kalutes/FRCDriversStation/Driver's Station Documentation/Board Easy Reference/Analog Breakout Board.png

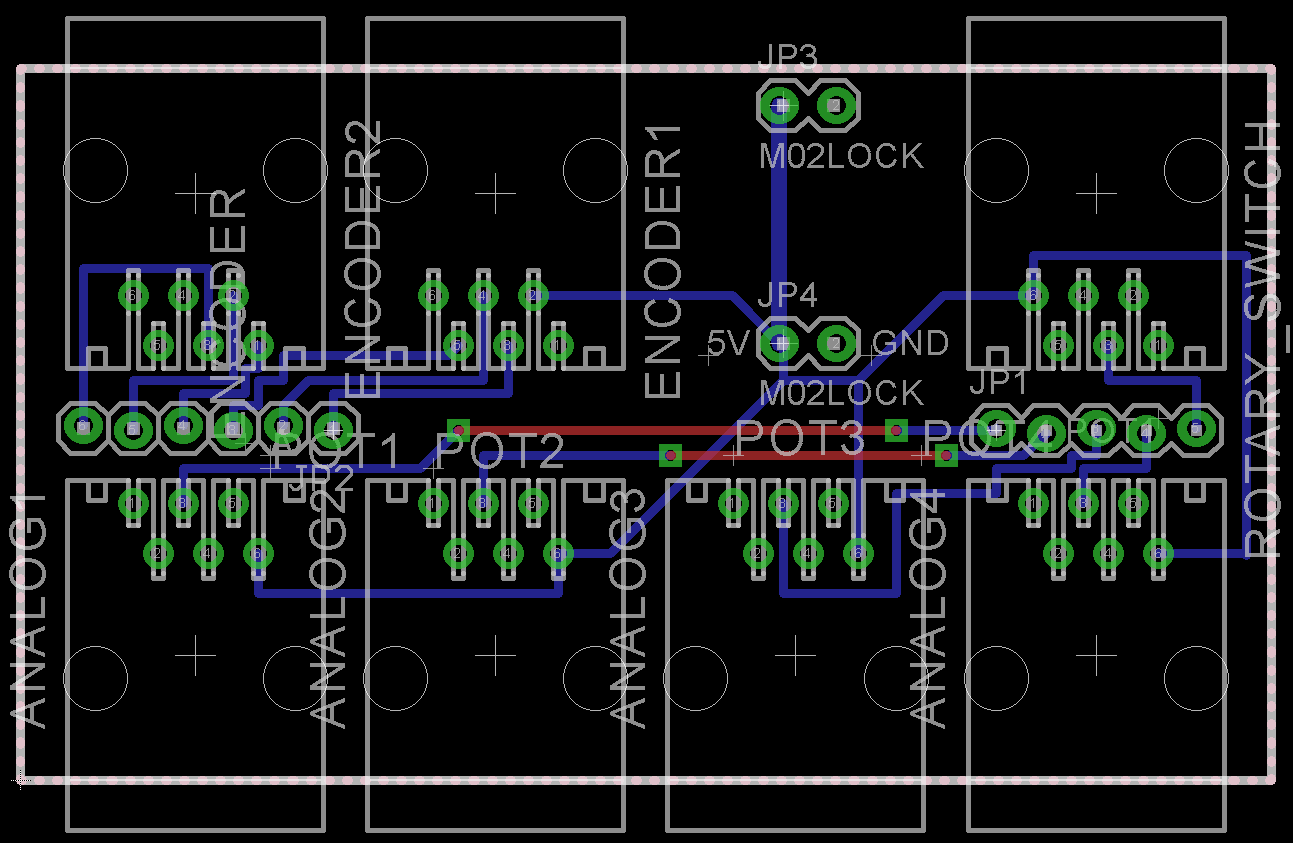
Driver's Station Documentation/Board Easy Reference/Analog Breakout Board.png
