kalutes/FRCDriversStation/Driver's Station Documentation/Board Easy Reference/Analog Breakout Schematic.png

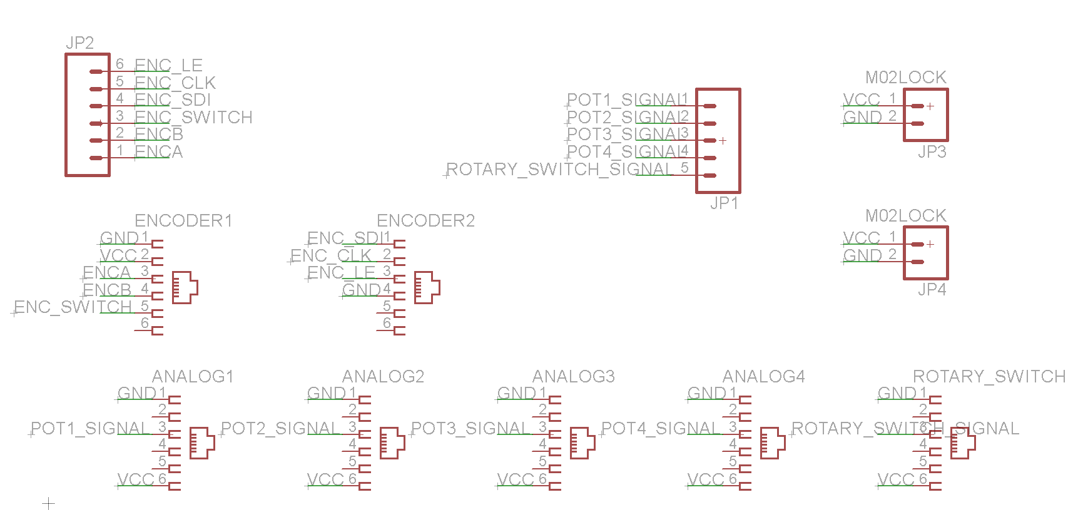
Driver's Station Documentation/Board Easy Reference/Analog Breakout Schematic.png
