kalutes/FRCDriversStation/Driver's Station Documentation/Board Easy Reference/Arduino Mega Breakout Board.png

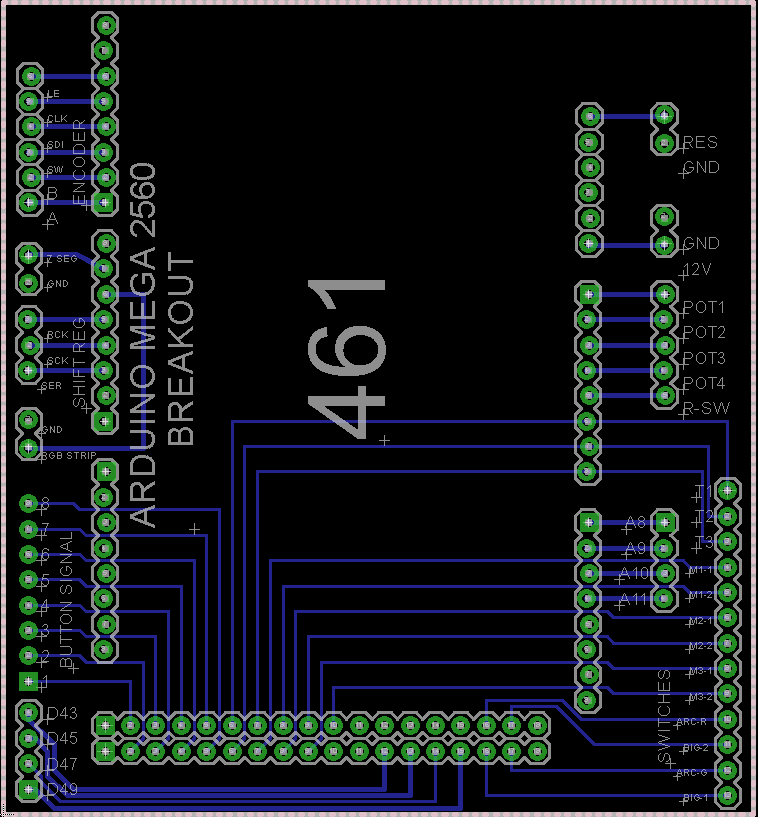
Driver's Station Documentation/Board Easy Reference/Arduino Mega Breakout Board.png
