kalutes/FRCDriversStation/Driver's Station Documentation/Board Easy Reference/Arduino Mega Breakout Schematic.png

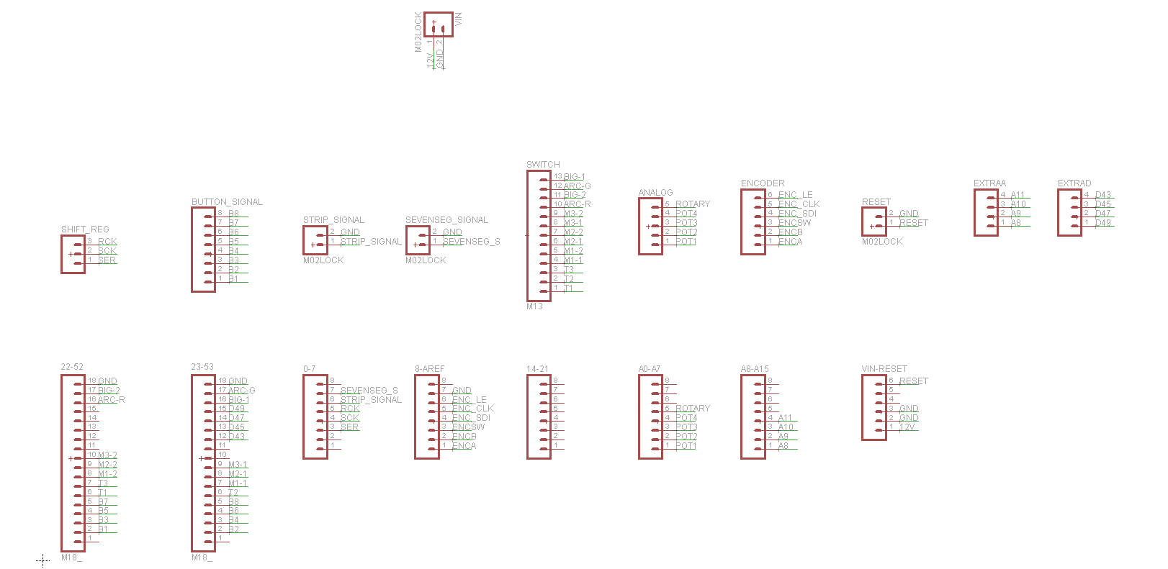
Driver's Station Documentation/Board Easy Reference/Arduino Mega Breakout Schematic.png
