kalutes/FRCDriversStation/Driver's Station Documentation/Board Easy Reference/LED Board Board.png

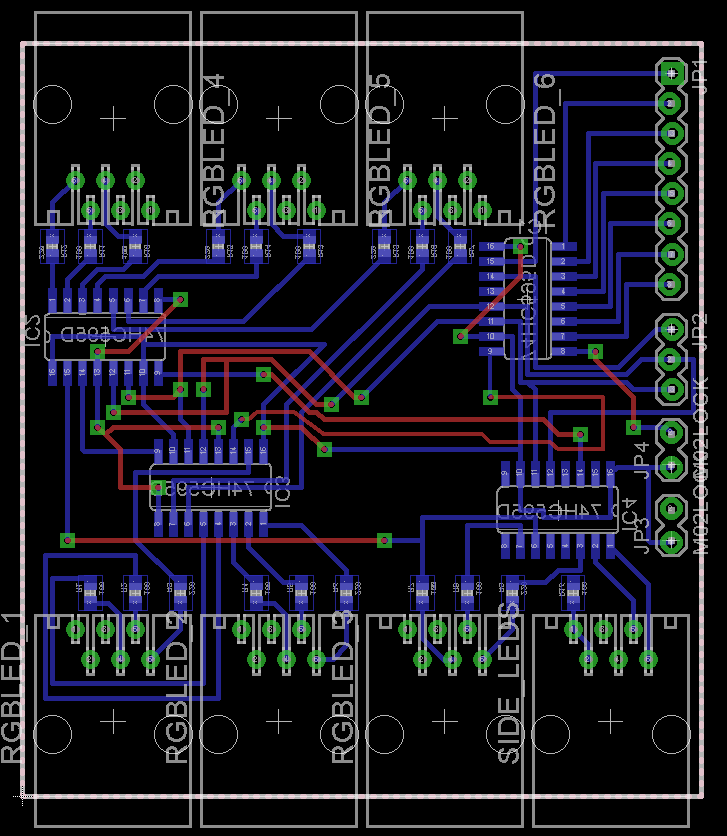
Driver's Station Documentation/Board Easy Reference/LED Board Board.png
