kalutes/FRCDriversStation/Driver's Station Documentation/Board Easy Reference/LED Board Schematic.png

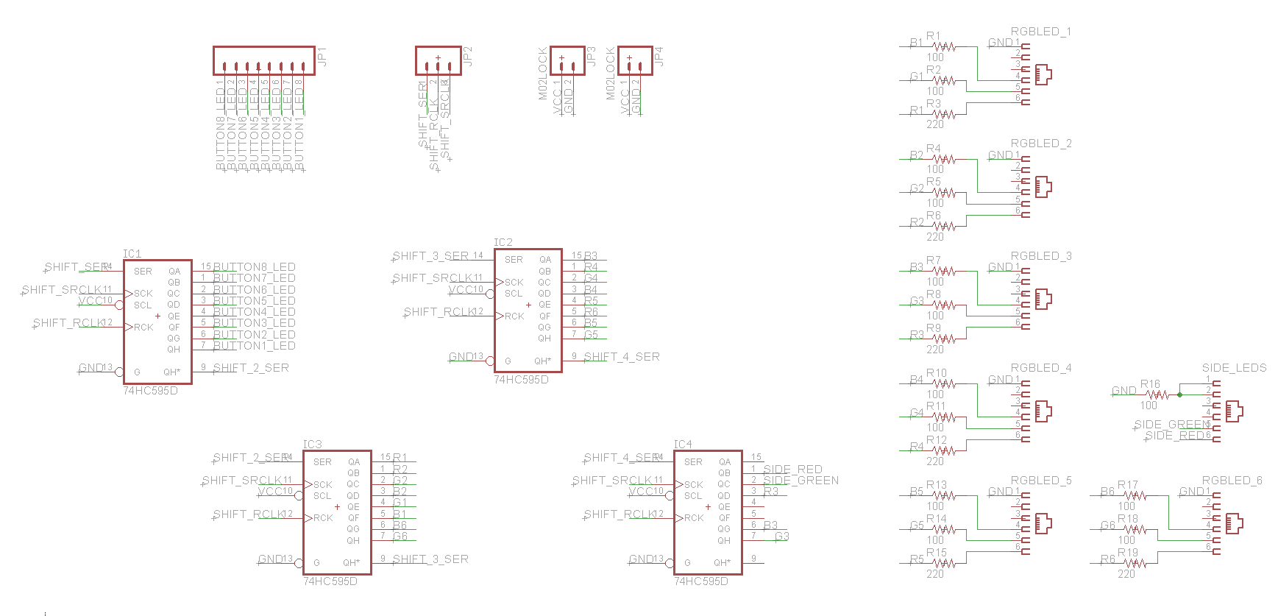
Driver's Station Documentation/Board Easy Reference/LED Board Schematic.png
