kalutes/FRCDriversStation/Driver's Station Documentation/Board Easy Reference/Pushbutton Breakout Board.png

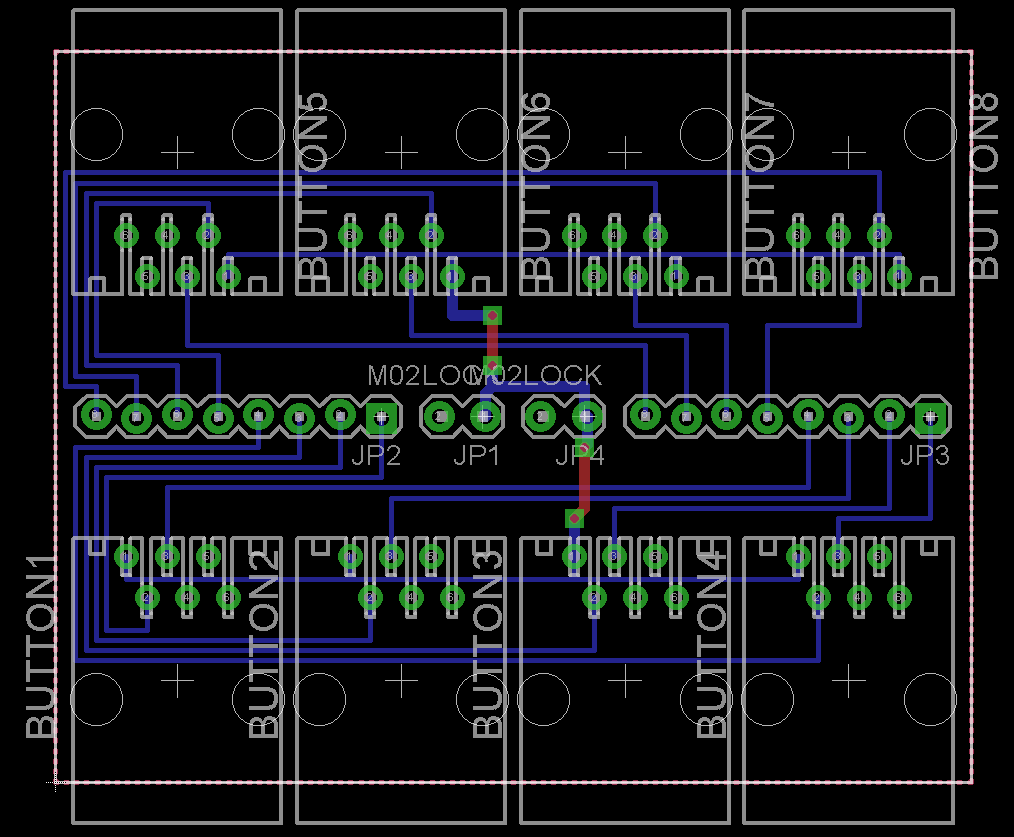
Driver's Station Documentation/Board Easy Reference/Pushbutton Breakout Board.png
