kalutes/FRCDriversStation/Driver's Station Documentation/Board Easy Reference/Pushbutton Breakout Schematic.png

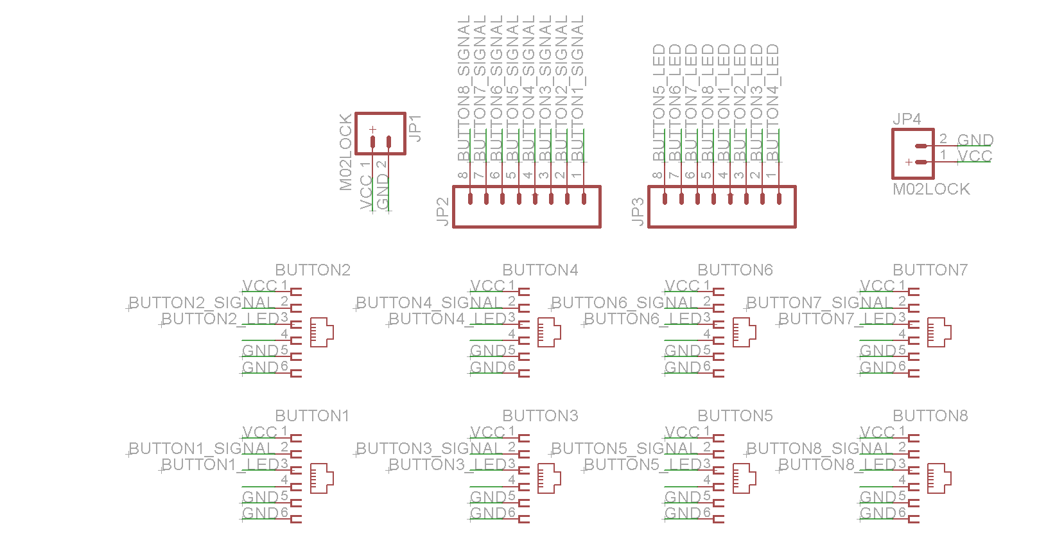
Driver's Station Documentation/Board Easy Reference/Pushbutton Breakout Schematic.png
