kalutes/FRCDriversStation/Driver's Station Documentation/Board Easy Reference/RGB LED Strips Board.png

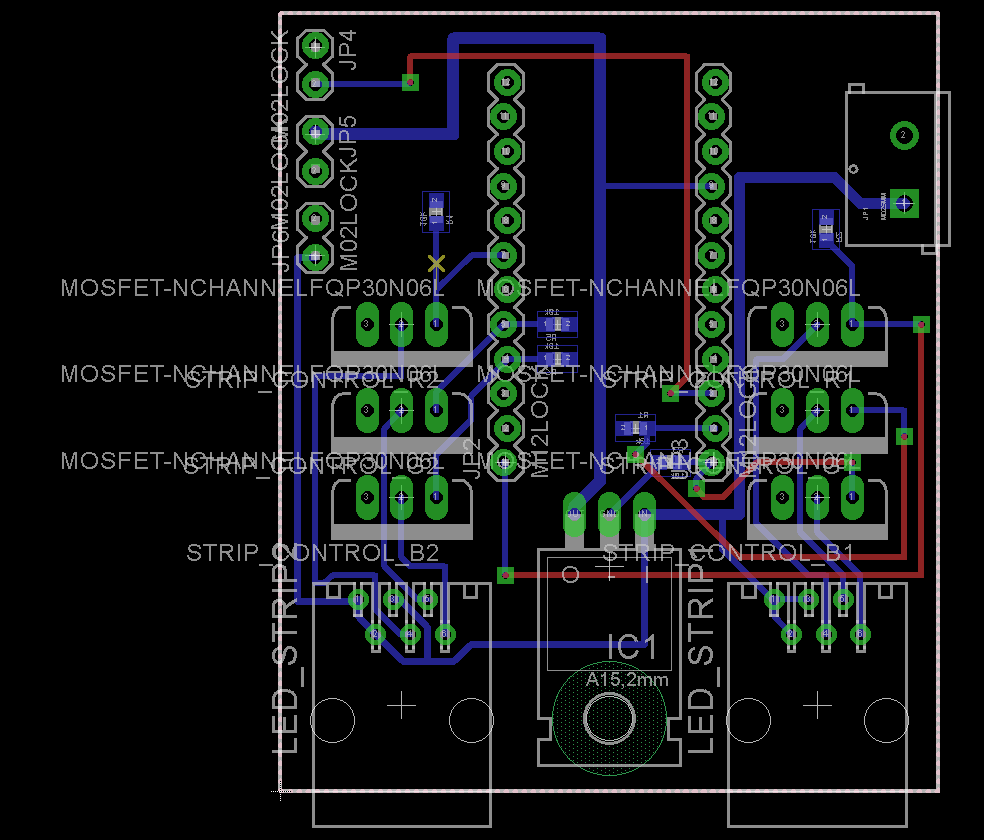
Driver's Station Documentation/Board Easy Reference/RGB LED Strips Board.png
