kalutes/FRCDriversStation/Driver's Station Documentation/Board Easy Reference/RGB LED Strips Schematic.png

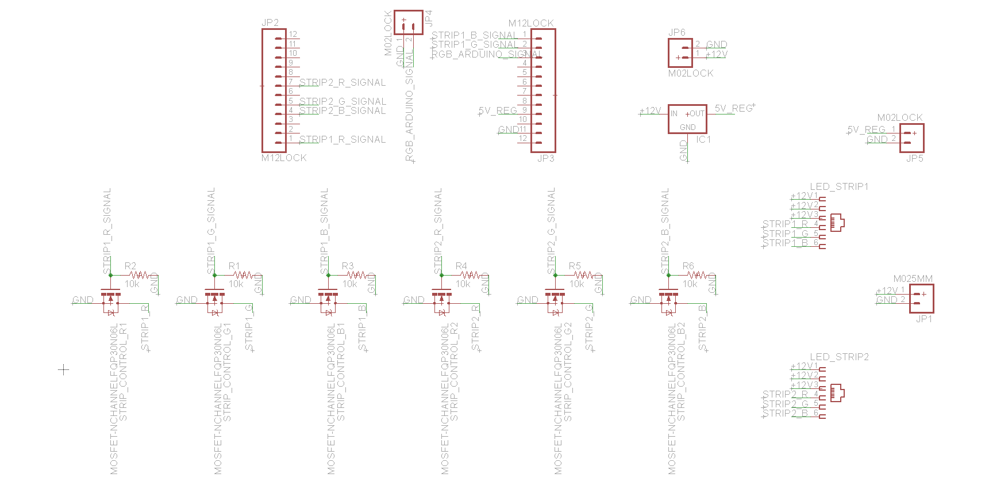
Driver's Station Documentation/Board Easy Reference/RGB LED Strips Schematic.png
