kalutes/FRCDriversStation/Driver's Station Documentation/Board Easy Reference/Seven Seg Control Board.png

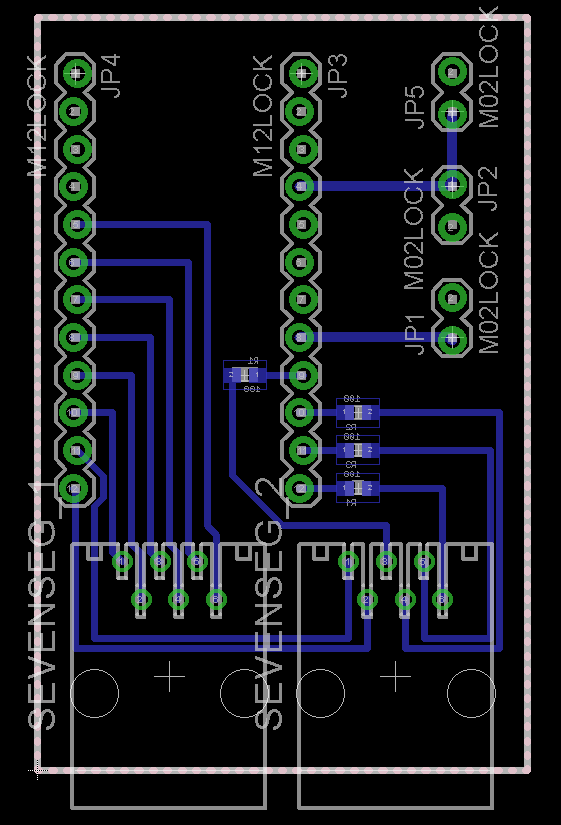
Driver's Station Documentation/Board Easy Reference/Seven Seg Control Board.png
