kalutes/FRCDriversStation/Driver's Station Documentation/Board Easy Reference/Seven Seg Control Schematic.png

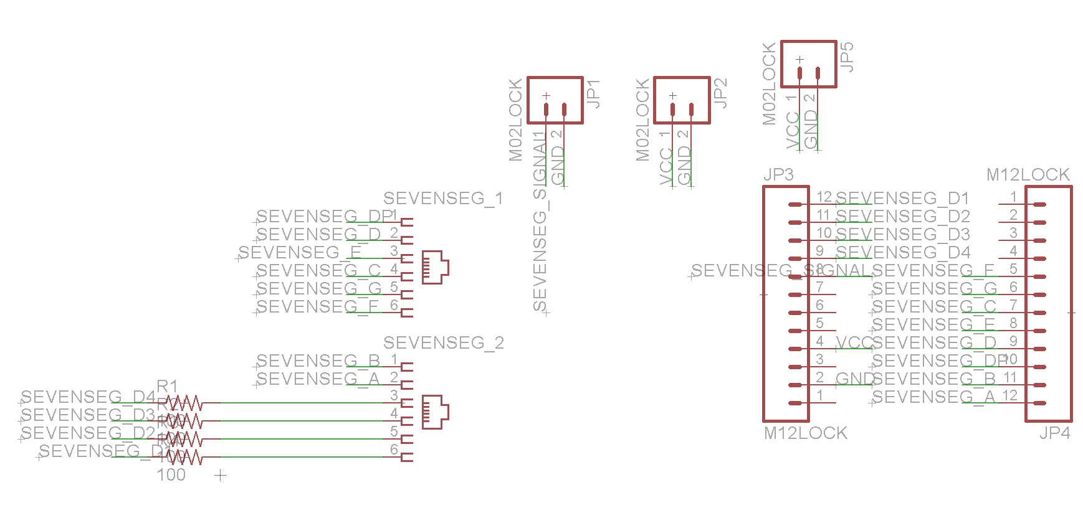
Driver's Station Documentation/Board Easy Reference/Seven Seg Control Schematic.png
