kalutes/FRCDriversStation/Driver's Station Documentation/Board Easy Reference/Switch Breakout Board.png

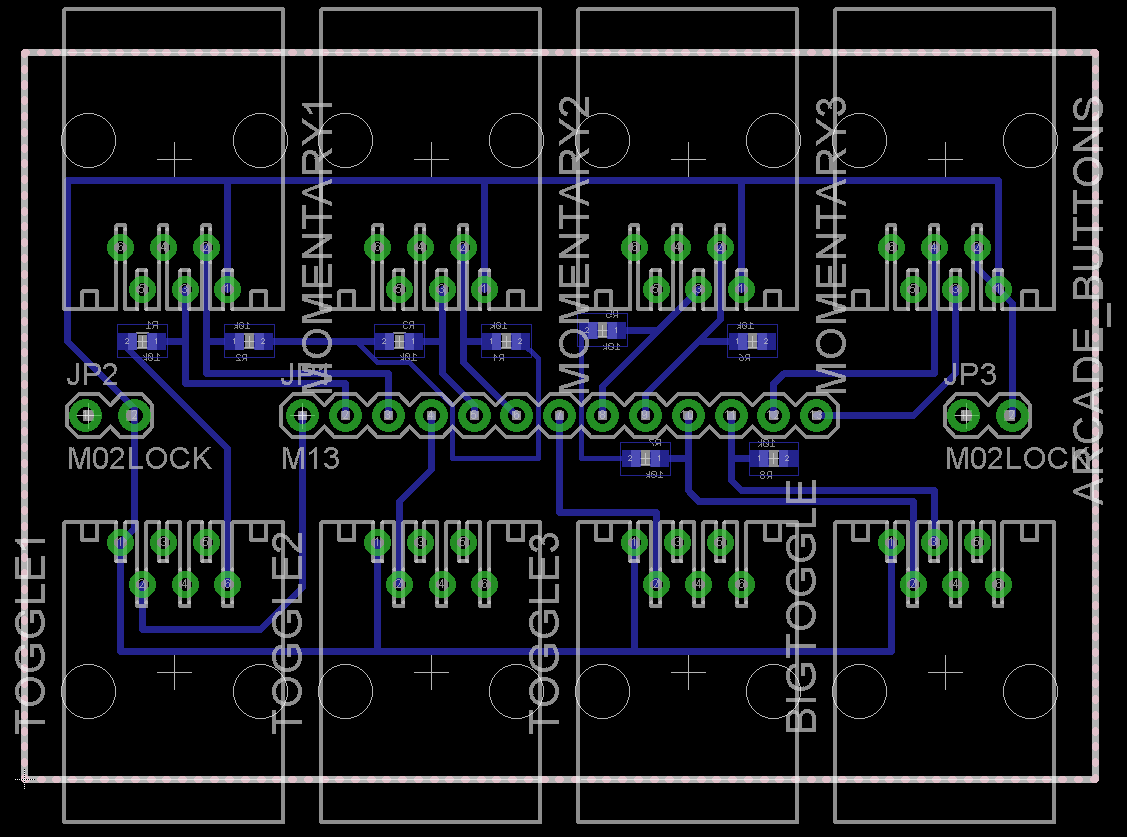
Driver's Station Documentation/Board Easy Reference/Switch Breakout Board.png
