kalutes/FRCDriversStation/Driver's Station Documentation/Board Easy Reference/Switch Breakout Schematic.png

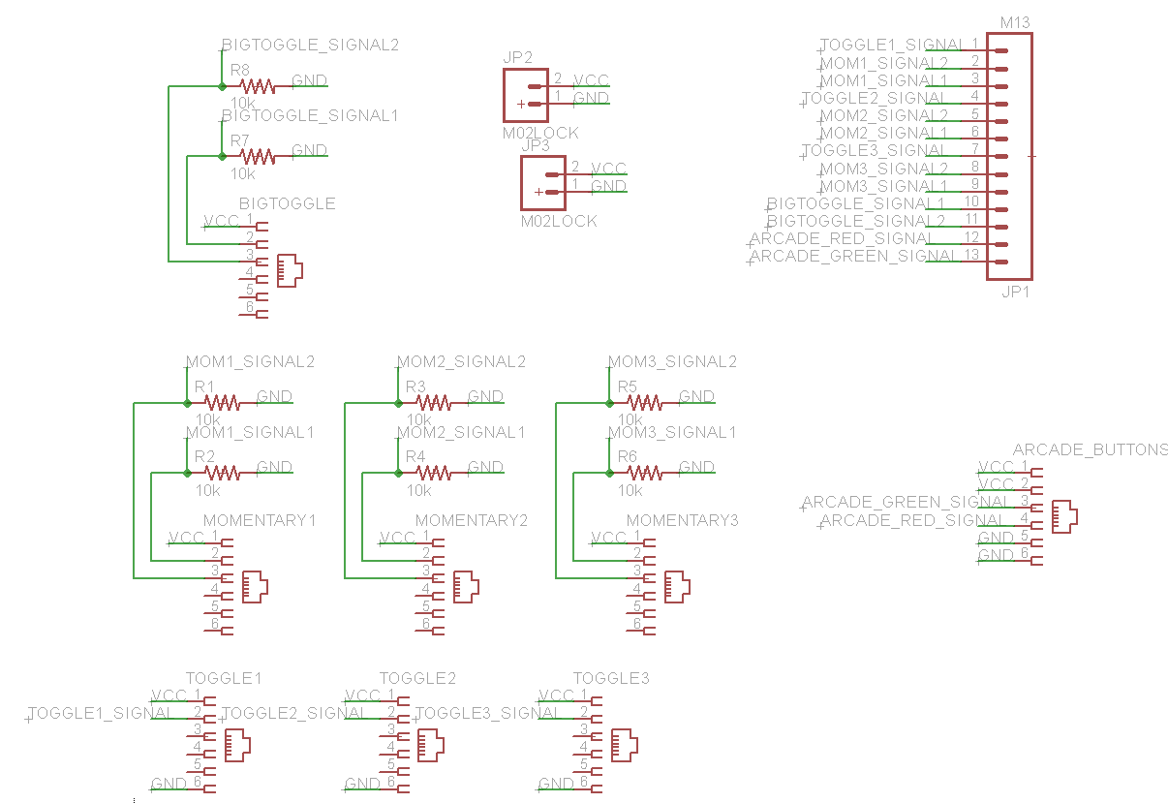
Driver's Station Documentation/Board Easy Reference/Switch Breakout Schematic.png
