kalutes/FRCDriversStation/Driver's Station Documentation/Eagle Files/Pushbutton Breakout/Pushbutton Breakout - Schematic.brd

## EAGLE design Driver's Station Documentation/Eagle Files/Pushbutton Breakout/Pushbutton Breakout - Schematic.brd (2016-06-20)

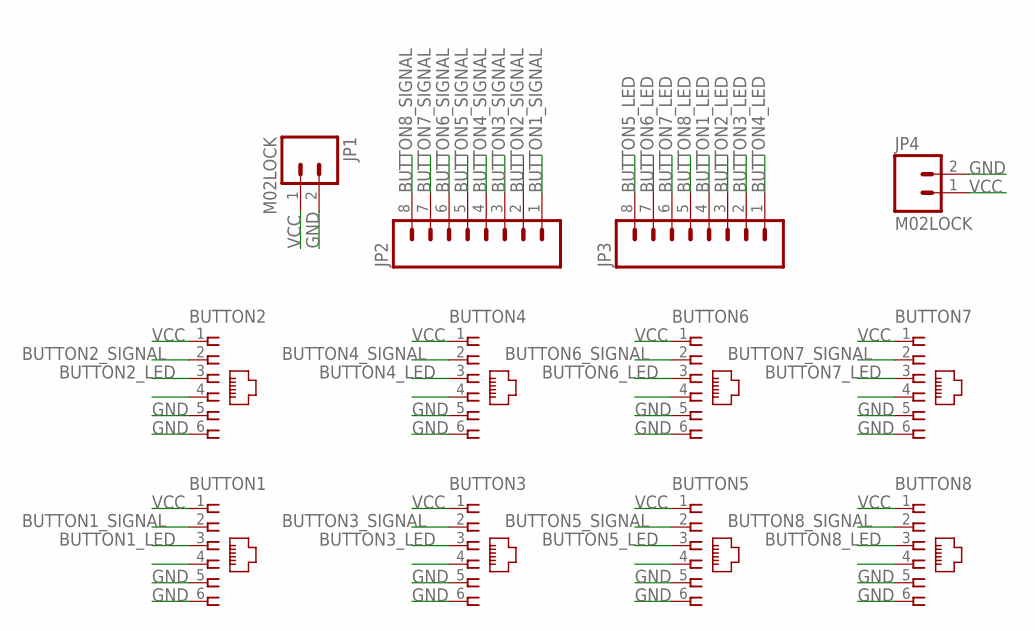
[picture p16: schematic Pushbutton Breakout - Schematic.sch]

Parts:
BUTTON1, BUTTON2, BUTTON3, BUTTON4, BUTTON5, BUTTON6, BUTTON7, BUTTON8: 555165-1
JP1, JP4: M02LOCK; 1X02_LOCK
JP2, JP3: M08LOCK; 1X08_LOCK

Connections:
BUTTON1_LED: BUTTON1.3, JP3.4
BUTTON1_SIGNAL: BUTTON1.2, JP2.1
BUTTON2_LED: BUTTON2.3, JP3.3
BUTTON2_SIGNAL: BUTTON2.2, JP2.2
BUTTON3_LED: BUTTON3.3, JP3.2
BUTTON3_SIGNAL: BUTTON3.2, JP2.3
BUTTON4_LED: BUTTON4.3, JP3.1
BUTTON4_SIGNAL: BUTTON4.2, JP2.4
BUTTON5_LED: BUTTON5.3, JP3.8
BUTTON5_SIGNAL: BUTTON5.2, JP2.5
BUTTON6_LED: BUTTON6.3, JP3.7
BUTTON6_SIGNAL: BUTTON6.2, JP2.6
BUTTON7_LED: BUTTON7.3, JP3.6
BUTTON7_SIGNAL: BUTTON7.2, JP2.7
BUTTON8_LED: BUTTON8.3, JP3.5
BUTTON8_SIGNAL: BUTTON8.2, JP2.8
GND: BUTTON1.5, BUTTON1.6, BUTTON2.5, BUTTON2.6, BUTTON3.5, BUTTON3.6, BUTTON4.5, BUTTON4.6, BUTTON5.5, BUTTON5.6, BUTTON6.5, BUTTON6.6, BUTTON7.5, BUTTON7.6, BUTTON8.5, BUTTON8.6, JP1.2, JP4.2
VCC: BUTTON1.1, BUTTON2.1, BUTTON3.1, BUTTON4.1, BUTTON5.1, BUTTON6.1, BUTTON7.1, BUTTON8.1, JP1.1, JP4.1

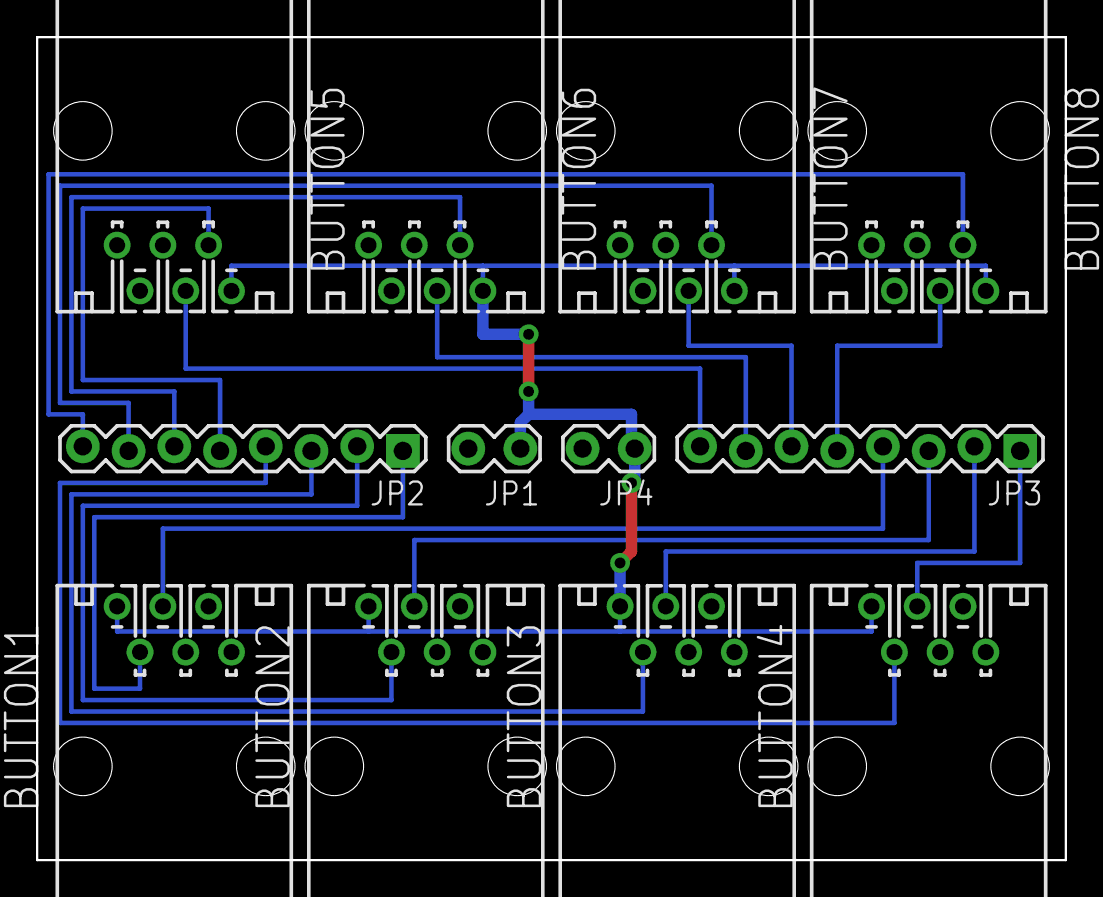
[picture p17: board Pushbutton Breakout - Schematic.brd from above]

Board: 2 copper layers, 57.1 x 45.7 mm, 12 parts (0 on the bottom side), 18 nets.
