kalutes/FRCDriversStation/Driver's Station Documentation/Eagle Files/Seven Seg Control/Seven Seg Control - Schematic.brd

## EAGLE design Driver's Station Documentation/Eagle Files/Seven Seg Control/Seven Seg Control - Schematic.brd (2016-06-20)

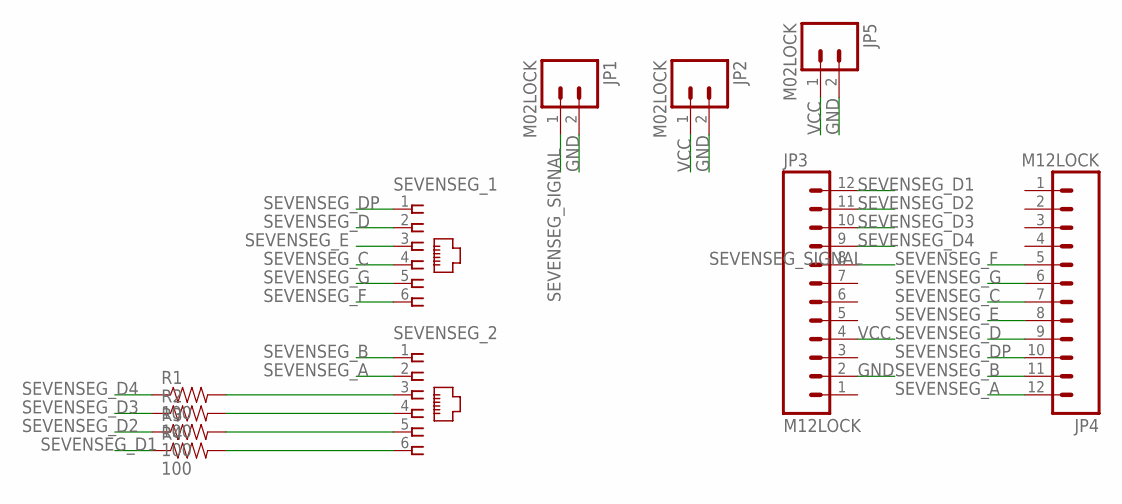
[picture p18: schematic Seven Seg Control - Schematic.sch]

Parts:
JP1, JP2, JP5: M02LOCK; 1X02_LOCK
JP3, JP4: M12LOCK; 1X12_LOCK
R1, R2, R3, R4: 100; 0603-RES
SEVENSEG_1, SEVENSEG_2: 555165-1

Connections:
GND: JP1.2, JP2.2, JP3.2, JP5.2
unnamed: R4.2, SEVENSEG_2.6
unnamed: R2.2, SEVENSEG_2.4
unnamed: R3.2, SEVENSEG_2.5
unnamed: R1.2, SEVENSEG_2.3
SEVENSEG_A: JP4.12, SEVENSEG_2.2
SEVENSEG_B: JP4.11, SEVENSEG_2.1
SEVENSEG_C: JP4.7, SEVENSEG_1.4
SEVENSEG_D: JP4.9, SEVENSEG_1.2
SEVENSEG_D1: JP3.12, R4.1
SEVENSEG_D2: JP3.11, R3.1
SEVENSEG_D3: JP3.10, R2.1
SEVENSEG_D4: JP3.9, R1.1
SEVENSEG_DP: JP4.10, SEVENSEG_1.1
SEVENSEG_E: JP4.8, SEVENSEG_1.3
SEVENSEG_F: JP4.5, SEVENSEG_1.6
SEVENSEG_G: JP4.6, SEVENSEG_1.5
SEVENSEG_SIGNAL: JP1.1, JP3.8
VCC: JP2.1, JP3.4, JP5.1

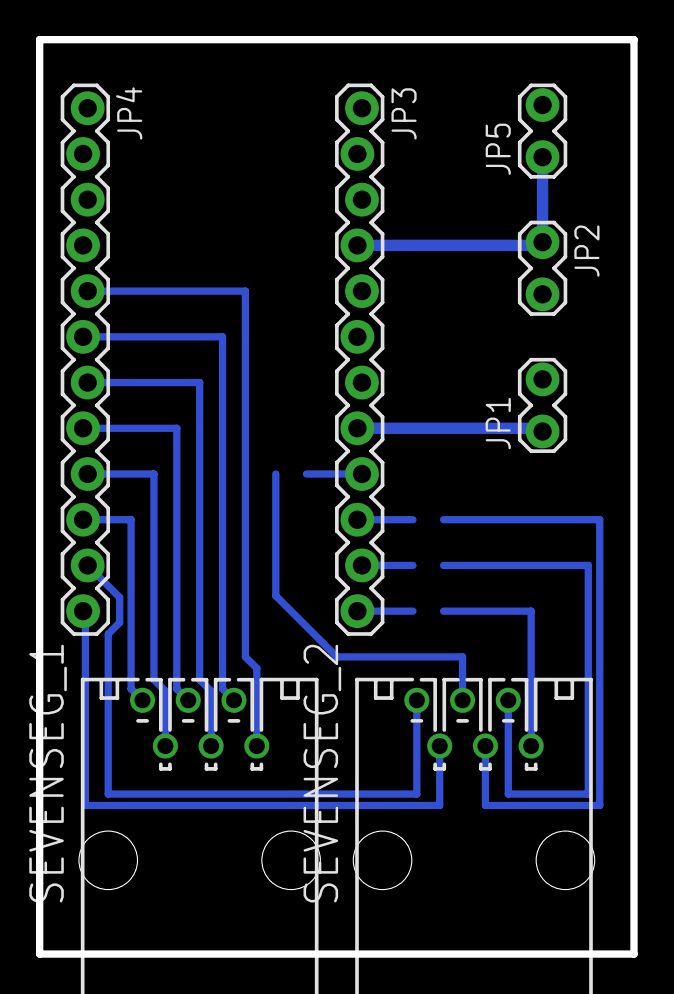
[picture p19: board Seven Seg Control - Schematic.brd from above]

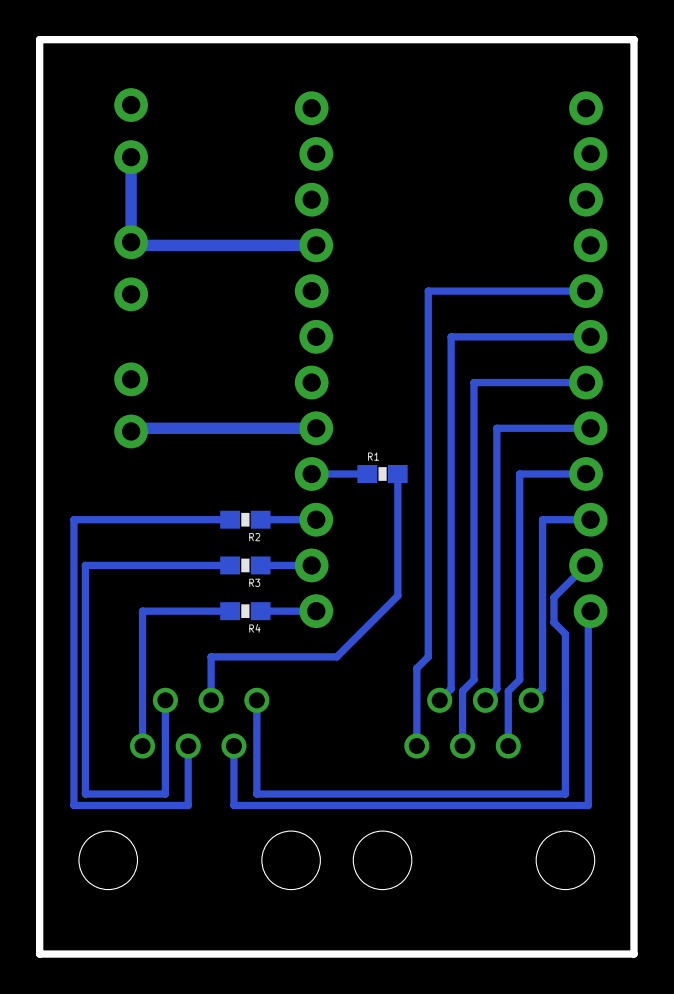
[picture p20: board Seven Seg Control - Schematic.brd from below]

Board: 2 copper layers, 33.0 x 50.8 mm, 11 parts (4 on the bottom side), 19 nets.
