kalutes/FRCDriversStation/Driver's Station Documentation/Eagle Files/Arduino Mega Breakout/Arduino Mega Breakout - Schematic.brd

## EAGLE design Driver's Station Documentation/Eagle Files/Arduino Mega Breakout/Arduino Mega Breakout - Schematic.brd (2016-06-20)

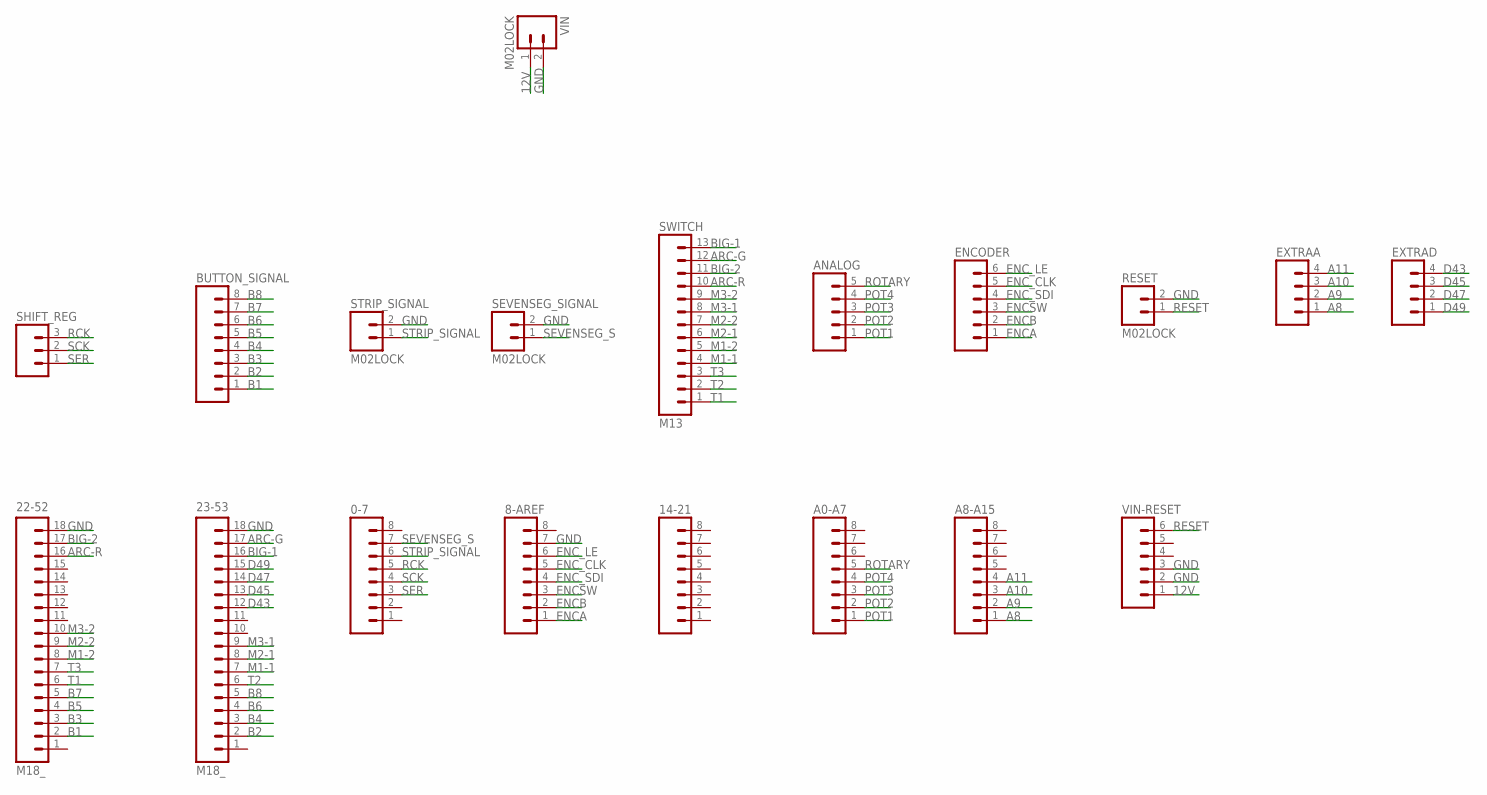
[picture p21: schematic Arduino Mega Breakout - Schematic.sch]

Parts:
0-7, 8-AREF, 14-21: M08LOCK; 1X08_LOCK
22-52, 23-53: M18_; 1X18
A0-A7, A8-A15: M08LOCK; 1X08_LOCK
ANALOG: M05LOCK; 1X05_LOCK
BUTTON_SIGNAL: M08; 1X08_PIN1_NO_SILK
ENCODER: M06LOCK; 1X06_LOCK
EXTRAA: M04LOCK; 1X04_LOCK
EXTRAD: M04PTH; 1X04
RESET: M02LOCK; 1X02_LOCK
SEVENSEG_SIGNAL: M02LOCK; 1X02_LOCK
SHIFT_REG: M03LOCK; 1X03_LOCK
STRIP_SIGNAL: M02LOCK; 1X02_LOCK
SWITCH: M13; 1X13
VIN: M02LOCK; 1X02_LOCK
VIN-RESET: M06LOCK; 1X06_LOCK

Connections:
12V: VIN.1, VIN-RESET.1
A8: A8-A15.1, EXTRAA.1
A9: A8-A15.2, EXTRAA.2
A10: A8-A15.3, EXTRAA.3
A11: A8-A15.4, EXTRAA.4
ARC-G: 23-53.17, SWITCH.12
ARC-R: 22-52.16, SWITCH.10
B1: 22-52.2, BUTTON_SIGNAL.1
B2: 23-53.2, BUTTON_SIGNAL.2
B3: 22-52.3, BUTTON_SIGNAL.3
B4: 23-53.3, BUTTON_SIGNAL.4
B5: 22-52.4, BUTTON_SIGNAL.5
B6: 23-53.4, BUTTON_SIGNAL.6
B7: 22-52.5, BUTTON_SIGNAL.7
B8: 23-53.5, BUTTON_SIGNAL.8
BIG-1: 23-53.16, SWITCH.13
BIG-2: 22-52.17, SWITCH.11
D43: 23-53.12, EXTRAD.4
D45: 23-53.13, EXTRAD.3
D47: 23-53.14, EXTRAD.2
D49: 23-53.15, EXTRAD.1
ENCA: 8-AREF.1, ENCODER.1
ENCB: 8-AREF.2, ENCODER.2
ENCSW: 8-AREF.3, ENCODER.3
ENC_CLK: 8-AREF.5, ENCODER.5
ENC_LE: 8-AREF.6, ENCODER.6
ENC_SDI: 8-AREF.4, ENCODER.4
GND: 8-AREF.7, 22-52.18, 23-53.18, RESET.2, SEVENSEG_SIGNAL.2, STRIP_SIGNAL.2, VIN.2, VIN-RESET.2, VIN-RESET.3
M1-1: 23-53.7, SWITCH.4
M1-2: 22-52.8, SWITCH.5
M2-1: 23-53.8, SWITCH.6
M2-2: 22-52.9, SWITCH.7
M3-1: 23-53.9, SWITCH.8
M3-2: 22-52.10, SWITCH.9
POT1: A0-A7.1, ANALOG.1
POT2: A0-A7.2, ANALOG.2
POT3: A0-A7.3, ANALOG.3
POT4: A0-A7.4, ANALOG.4
RCK: 0-7.5, SHIFT_REG.3
RESET: RESET.1, VIN-RESET.6
ROTARY: A0-A7.5, ANALOG.5
SCK: 0-7.4, SHIFT_REG.2
SER: 0-7.3, SHIFT_REG.1
SEVENSEG_S: 0-7.7, SEVENSEG_SIGNAL.1
STRIP_SIGNAL: 0-7.6, STRIP_SIGNAL.1
T1: 22-52.6, SWITCH.1
T2: 23-53.6, SWITCH.2
T3: 22-52.7, SWITCH.3

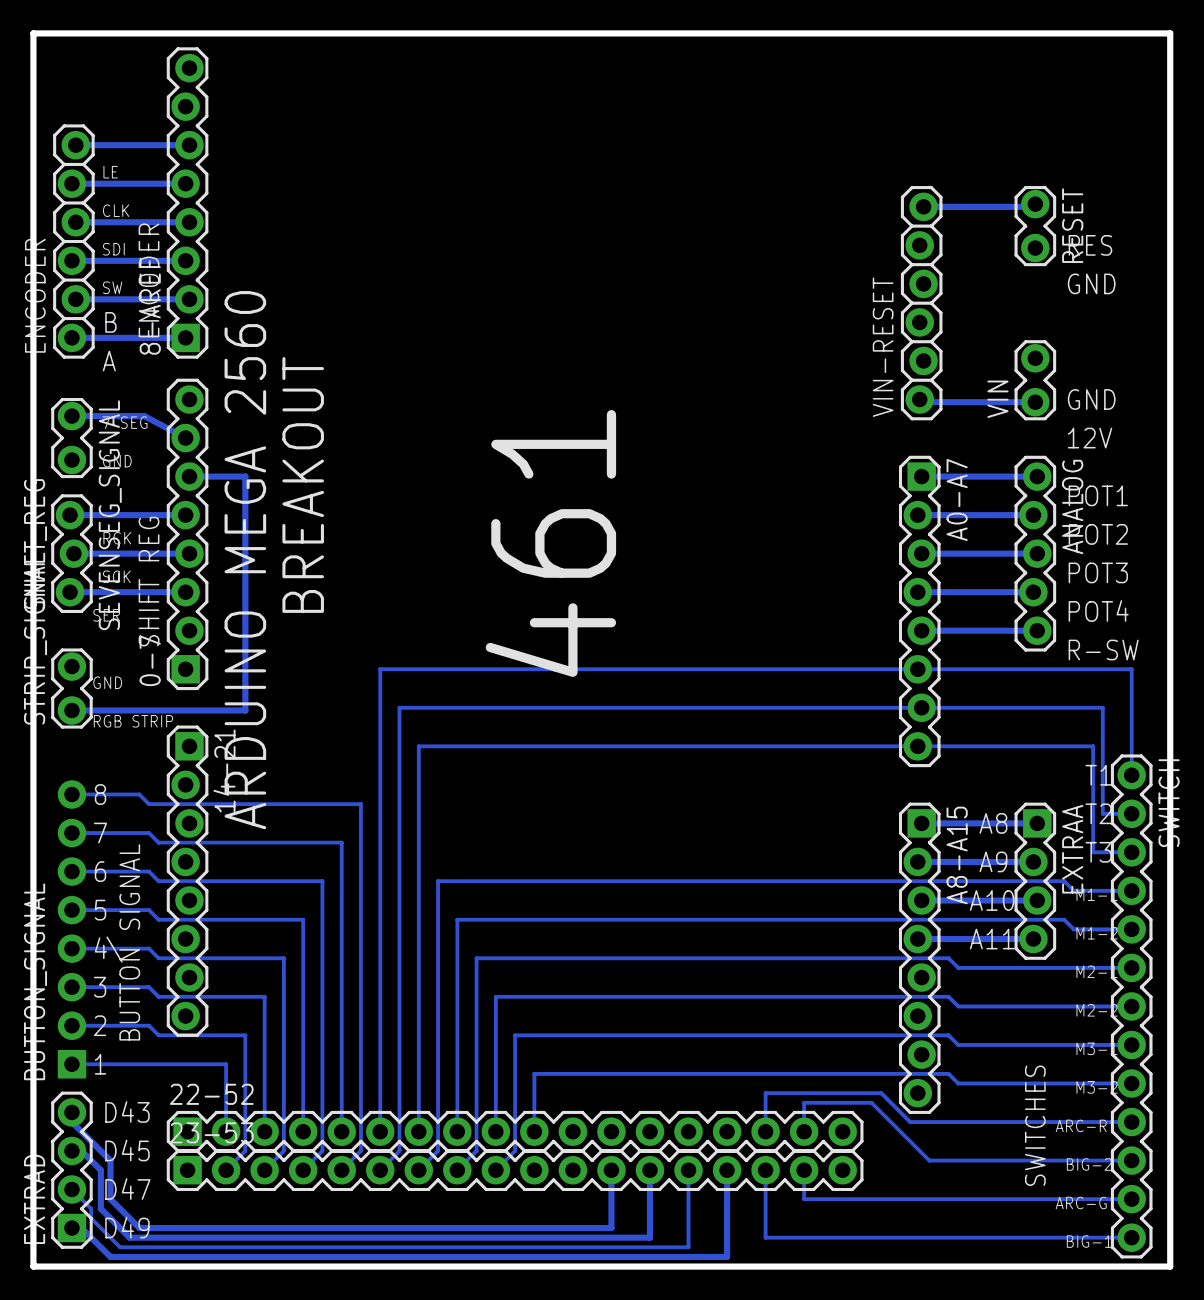
[picture p22: board Arduino Mega Breakout - Schematic.brd from above]

Board: 2 copper layers, 74.9 x 81.3 mm, 19 parts (0 on the bottom side), 48 nets.
