kalutes/FRCDriversStation/Driver's Station Documentation/Eagle Files/RGB LEDs/LED Strips - Schematic.brd

## EAGLE design Driver's Station Documentation/Eagle Files/RGB LEDs/LED Strips - Schematic.brd (2016-06-20)

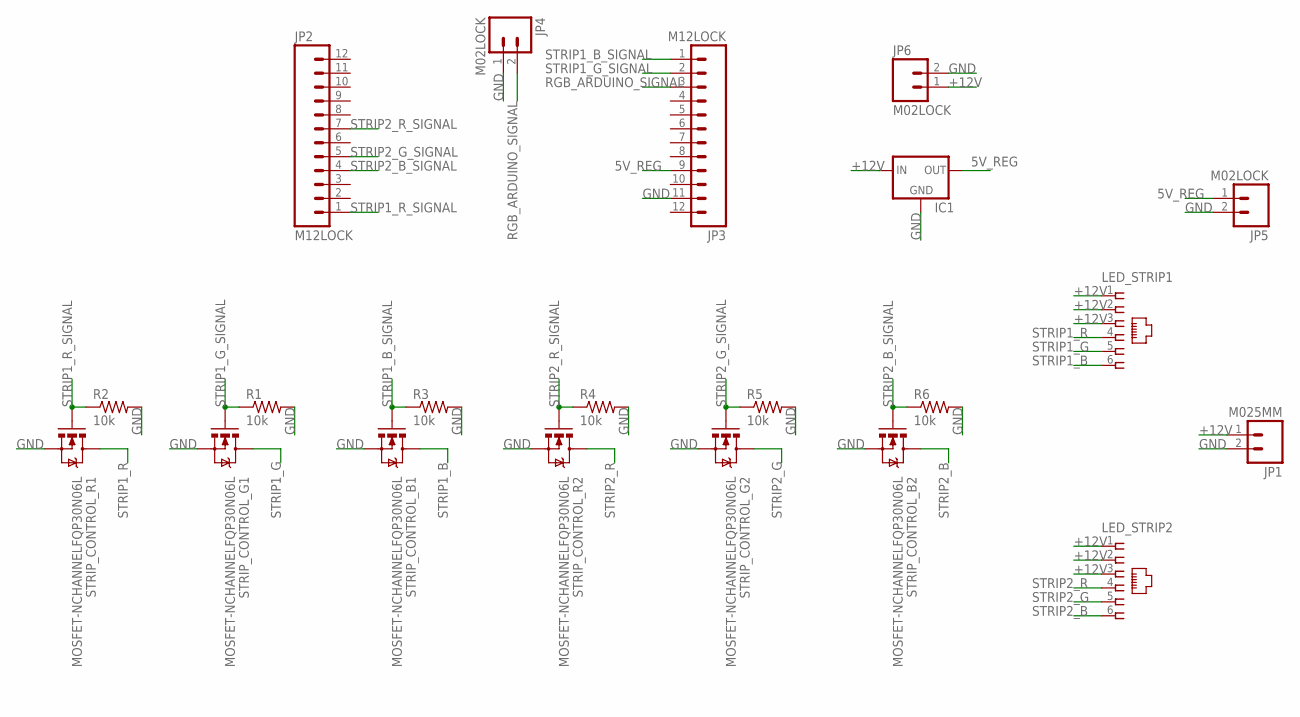
[picture p23: schematic LED Strips - Schematic.sch]

Parts:
IC1: V_REG_78XXSIDE; 78XXL
JP1: M025MM; SCREWTERMINAL-5MM-2
JP2, JP3: M12LOCK; 1X12_LOCK
JP4, JP5, JP6: M02LOCK; 1X02_LOCK
LED_STRIP1, LED_STRIP2: 555165-1
R1, R2, R3, R4, R5, R6: 10k; 0603-RES
STRIP_CONTROL_B1, STRIP_CONTROL_B2: MOSFET-NCHANNELFQP30N06L; TO220V
STRIP_CONTROL_G1, STRIP_CONTROL_G2: MOSFET-NCHANNELFQP30N06L; TO220V
STRIP_CONTROL_R1, STRIP_CONTROL_R2: MOSFET-NCHANNELFQP30N06L; TO220V

Connections:
5V_REG: IC1.OUT, JP3.9, JP5.1
+12V: IC1.IN, JP1.1, JP6.1, LED_STRIP1.1, LED_STRIP1.2, LED_STRIP1.3, LED_STRIP2.1, LED_STRIP2.2, LED_STRIP2.3
GND: IC1.GND, JP1.2, JP3.11, JP4.1, JP5.2, JP6.2, R1.2, R2.2, R3.2, R4.2, R5.2, R6.2, STRIP_CONTROL_B1.3 (S), STRIP_CONTROL_B2.3 (S), STRIP_CONTROL_G1.3 (S), STRIP_CONTROL_G2.3 (S), STRIP_CONTROL_R1.3 (S), STRIP_CONTROL_R2.3 (S)
RGB_ARDUINO_SIGNAL: JP3.3, JP4.2
STRIP1_B: LED_STRIP1.6, STRIP_CONTROL_B1.2 (D)
STRIP1_B_SIGNAL: JP3.1, R3.1, STRIP_CONTROL_B1.1 (G)
STRIP1_G: LED_STRIP1.5, STRIP_CONTROL_G1.2 (D)
STRIP1_G_SIGNAL: JP3.2, R1.1, STRIP_CONTROL_G1.1 (G)
STRIP1_R: LED_STRIP1.4, STRIP_CONTROL_R1.2 (D)
STRIP1_R_SIGNAL: JP2.1, R2.1, STRIP_CONTROL_R1.1 (G)
STRIP2_B: LED_STRIP2.6, STRIP_CONTROL_B2.2 (D)
STRIP2_B_SIGNAL: JP2.4, R6.1, STRIP_CONTROL_B2.1 (G)
STRIP2_G: LED_STRIP2.5, STRIP_CONTROL_G2.2 (D)
STRIP2_G_SIGNAL: JP2.5, R5.1, STRIP_CONTROL_G2.1 (G)
STRIP2_R: LED_STRIP2.4, STRIP_CONTROL_R2.2 (D)
STRIP2_R_SIGNAL: JP2.7, R4.1, STRIP_CONTROL_R2.1 (G)

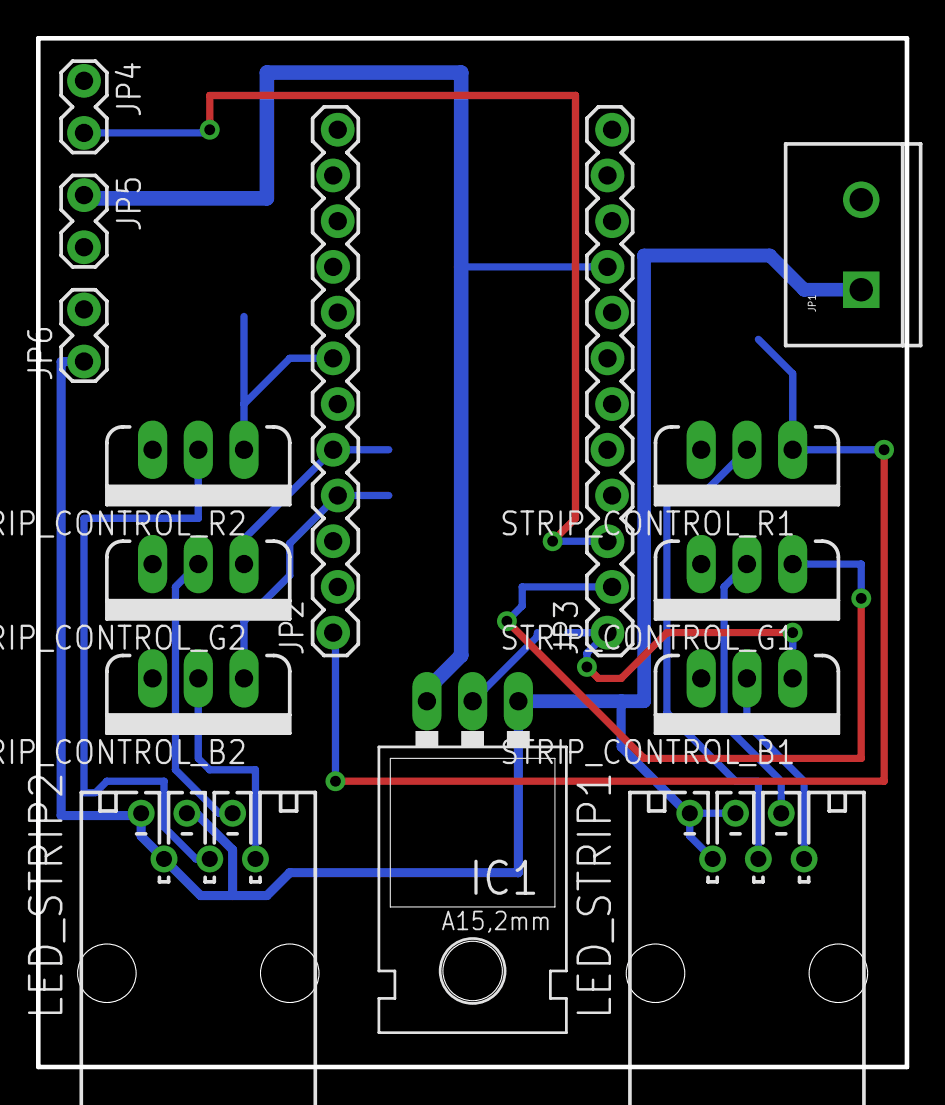
[picture p24: board LED Strips - Schematic.brd from above]

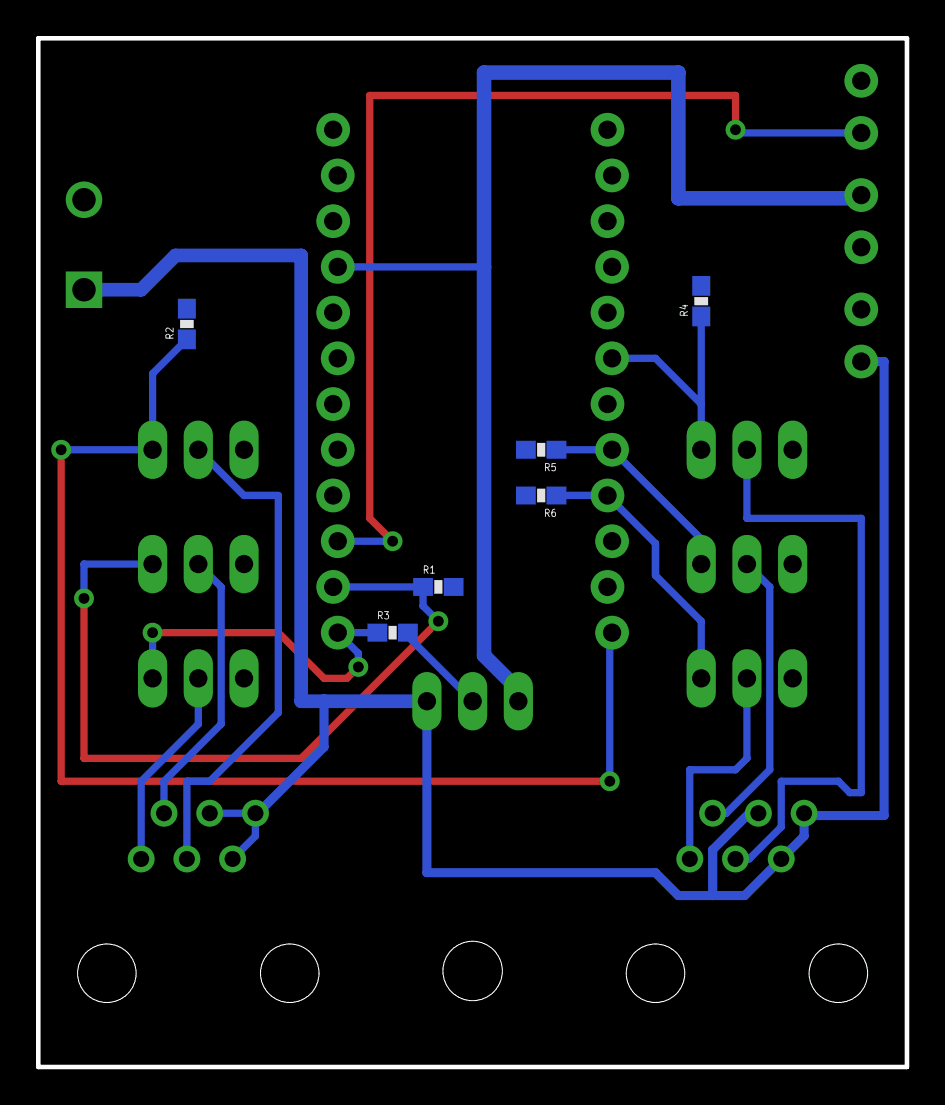
[picture p25: board LED Strips - Schematic.brd from below]

Board: 2 copper layers, 48.3 x 57.1 mm, 21 parts (6 on the bottom side), 16 nets.
