kalutes/FRCDriversStation/Driver's Station Documentation/Eagle Files/Switch Breakout/Switch Breakout - Schematic.brd

## EAGLE design Driver's Station Documentation/Eagle Files/Switch Breakout/Switch Breakout - Schematic.brd (2016-06-20)

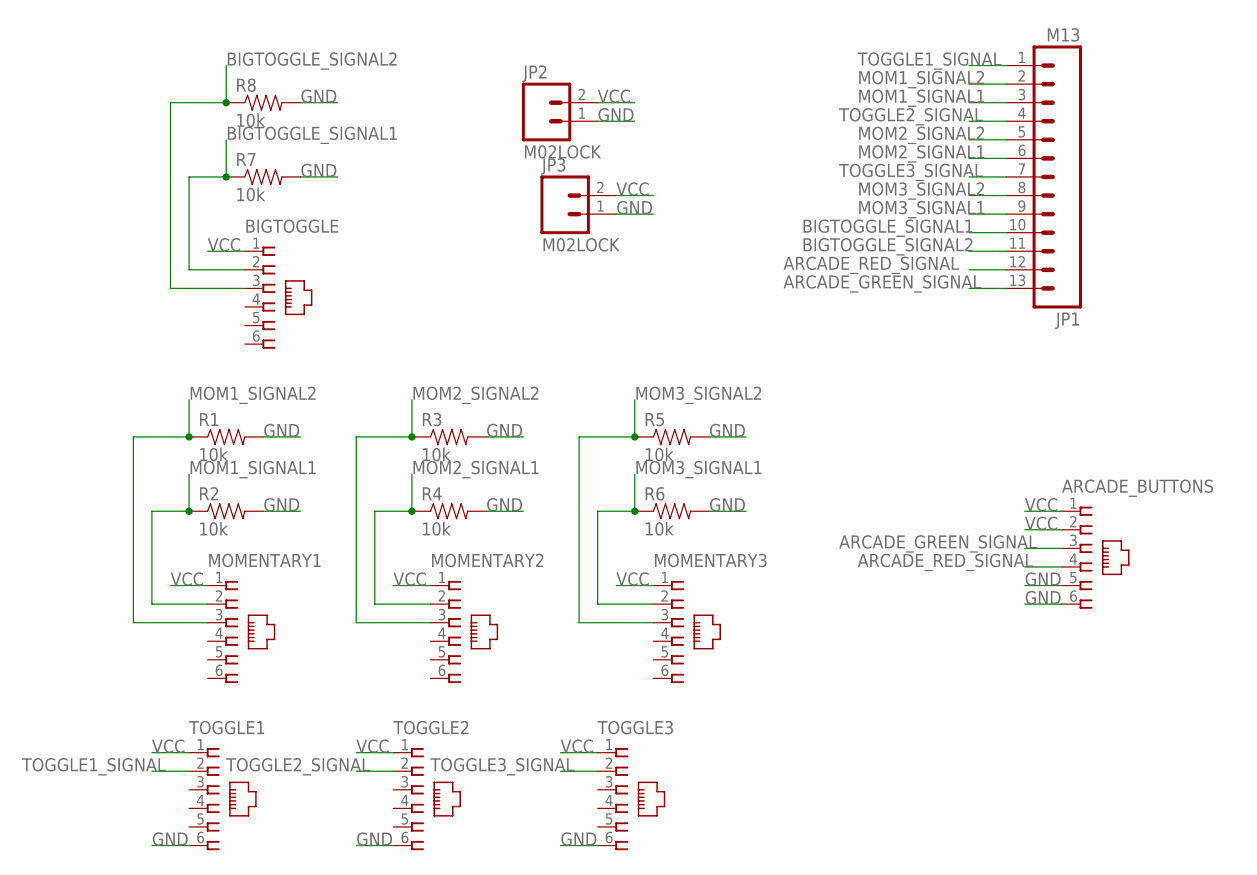
[picture p26: schematic Switch Breakout - Schematic.sch]

Parts:
ARCADE_BUTTONS: 555165-1
BIGTOGGLE: 555165-1
JP1: M13; 1X13
JP2, JP3: M02LOCK; 1X02_LOCK
MOMENTARY1, MOMENTARY2, MOMENTARY3: 555165-1
R1, R2, R3, R4, R5, R6, R7, R8: 10k; 0603-RES
TOGGLE1, TOGGLE2, TOGGLE3: 555165-1

Connections:
ARCADE_GREEN_SIGNAL: ARCADE_BUTTONS.3, JP1.13
ARCADE_RED_SIGNAL: ARCADE_BUTTONS.4, JP1.12
BIGTOGGLE_SIGNAL1: BIGTOGGLE.2, JP1.10, R7.1
BIGTOGGLE_SIGNAL2: BIGTOGGLE.3, JP1.11, R8.1
GND: ARCADE_BUTTONS.5, ARCADE_BUTTONS.6, JP2.1, JP3.1, R1.2, R2.2, R3.2, R4.2, R5.2, R6.2, R7.2, R8.2, TOGGLE1.6, TOGGLE2.6, TOGGLE3.6
MOM1_SIGNAL1: JP1.3, MOMENTARY1.2, R2.1
MOM1_SIGNAL2: JP1.2, MOMENTARY1.3, R1.1
MOM2_SIGNAL1: JP1.6, MOMENTARY2.2, R4.1
MOM2_SIGNAL2: JP1.5, MOMENTARY2.3, R3.1
MOM3_SIGNAL1: JP1.9, MOMENTARY3.2, R6.1
MOM3_SIGNAL2: JP1.8, MOMENTARY3.3, R5.1
TOGGLE1_SIGNAL: JP1.1, TOGGLE1.2
TOGGLE2_SIGNAL: JP1.4, TOGGLE2.2
TOGGLE3_SIGNAL: JP1.7, TOGGLE3.2
VCC: ARCADE_BUTTONS.1, ARCADE_BUTTONS.2, BIGTOGGLE.1, JP2.2, JP3.2, MOMENTARY1.1, MOMENTARY2.1, MOMENTARY3.1, TOGGLE1.1, TOGGLE2.1, TOGGLE3.1

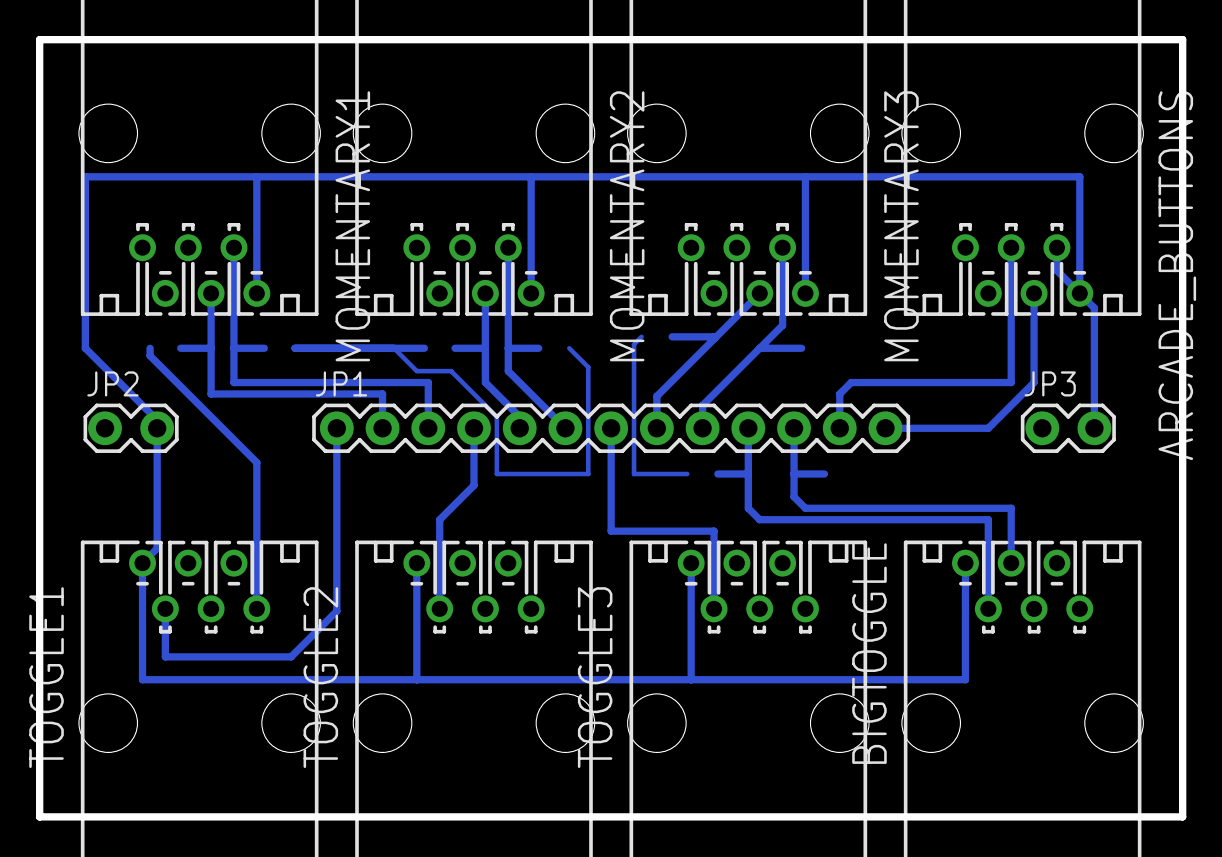
[picture p27: board Switch Breakout - Schematic.brd from above]

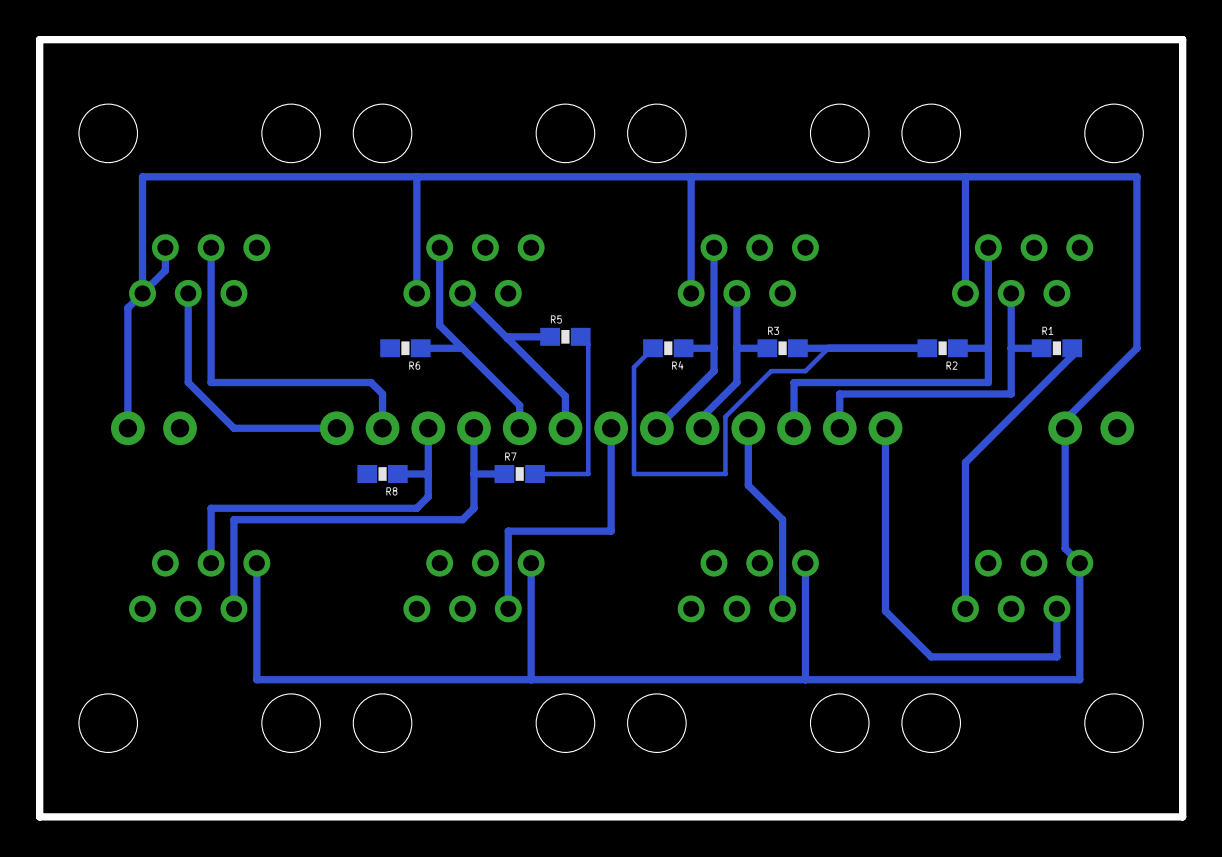
[picture p28: board Switch Breakout - Schematic.brd from below]

Board: 2 copper layers, 63.5 x 43.2 mm, 19 parts (8 on the bottom side), 15 nets.
