kalutes/FRCDriversStation/Driver's Station Documentation/Eagle Files/LED Board/LEDs - Schematic.brd

## EAGLE design Driver's Station Documentation/Eagle Files/LED Board/LEDs - Schematic.brd (2016-06-20)

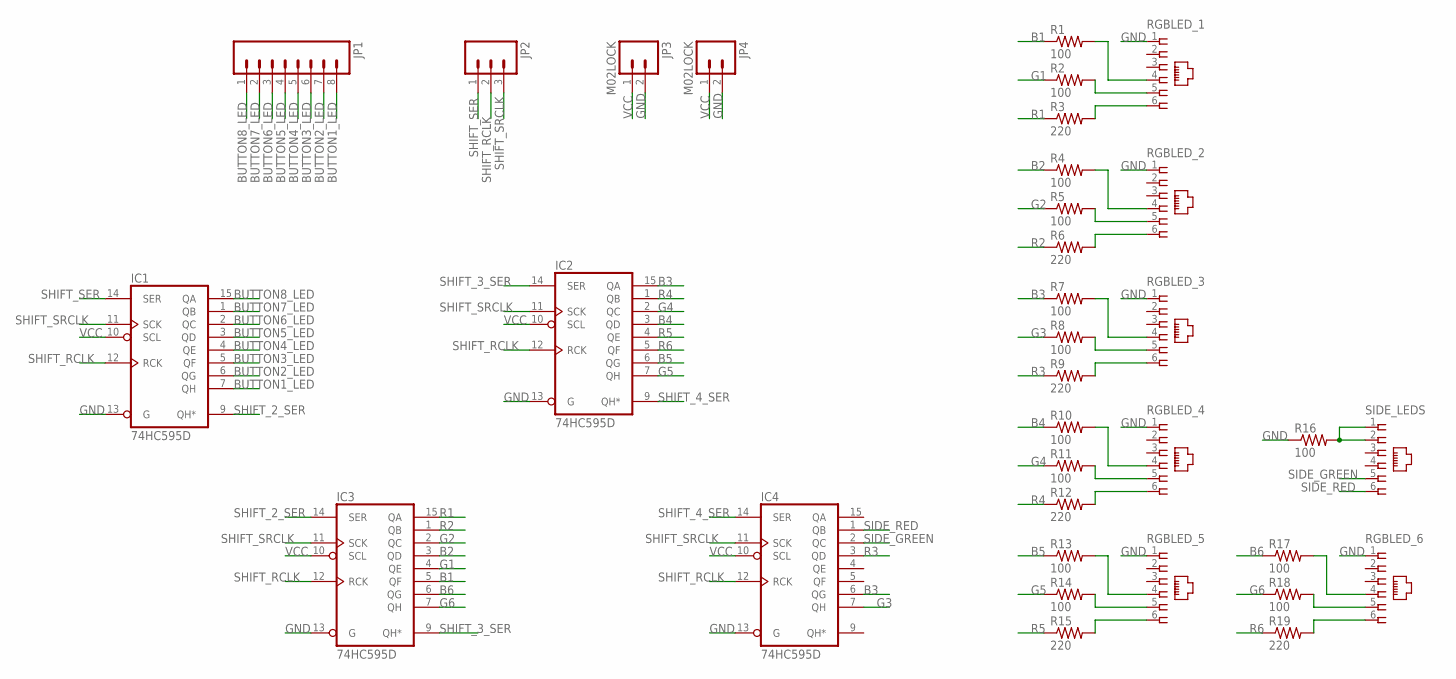
[picture p29: schematic LEDs - Schematic.sch]

Parts:
IC1, IC2, IC3, IC4: 74HC595D; SO16
JP1: M08LOCK; 1X08_LOCK
JP2: M03LOCK; 1X03_LOCK
JP3, JP4: M02LOCK; 1X02_LOCK
R1, R2, R4, R5, R7, R8, R10, R11, R13, R14, R16, R17, R18: 100; 0603-RES
R3, R6, R9, R12, R15, R19: 220; 0603-RES
RGBLED_1, RGBLED_2, RGBLED_3, RGBLED_4, RGBLED_5, RGBLED_6: 555165-1
SIDE_LEDS: 555165-1

Connections:
B1: IC3.5 (QF), R1.1
B2: IC3.3 (QD), R4.1
B3: IC2.15 (QA), IC4.6 (QG), R7.1
B4: IC2.3 (QD), R10.1
B5: IC2.6 (QG), R13.1
B6: IC3.6 (QG), R17.1
BUTTON1_LED: IC1.7 (QH), JP1.8
BUTTON2_LED: IC1.6 (QG), JP1.7
BUTTON3_LED: IC1.5 (QF), JP1.6
BUTTON4_LED: IC1.4 (QE), JP1.5
BUTTON5_LED: IC1.3 (QD), JP1.4
BUTTON6_LED: IC1.2 (QC), JP1.3
BUTTON7_LED: IC1.1 (QB), JP1.2
BUTTON8_LED: IC1.15 (QA), JP1.1
G1: IC3.4 (QE), R2.1
G2: IC3.2 (QC), R5.1
G3: IC4.7 (QH), R8.1
G4: IC2.2 (QC), R11.1
G5: IC2.7 (QH), R14.1
G6: IC3.7 (QH), R18.1
GND: IC1.8 (GND), IC1.13 (G), IC2.8 (GND), IC2.13 (G), IC3.8 (GND), IC3.13 (G), IC4.8 (GND), IC4.13 (G), JP3.2, JP4.2, R16.1, RGBLED_1.1, RGBLED_2.1, RGBLED_3.1, RGBLED_4.1, RGBLED_5.1, RGBLED_6.1
unnamed: R1.2, RGBLED_1.4
unnamed: R2.2, RGBLED_1.5
unnamed: R3.2, RGBLED_1.6
unnamed: R4.2, RGBLED_2.4
unnamed: R5.2, RGBLED_2.5
unnamed: R6.2, RGBLED_2.6
unnamed: R7.2, RGBLED_3.4
unnamed: R8.2, RGBLED_3.5
unnamed: R9.2, RGBLED_3.6
unnamed: R10.2, RGBLED_4.4
unnamed: R11.2, RGBLED_4.5
unnamed: R12.2, RGBLED_4.6
unnamed: R13.2, RGBLED_5.4
unnamed: R14.2, RGBLED_5.5
unnamed: R15.2, RGBLED_5.6
unnamed: R17.2, RGBLED_6.4
unnamed: R18.2, RGBLED_6.5
unnamed: R19.2, RGBLED_6.6
unnamed: R16.2, SIDE_LEDS.1, SIDE_LEDS.2
R1: IC3.15 (QA), R3.1
R2: IC3.1 (QB), R6.1
R3: IC4.3 (QD), R9.1
R4: IC2.1 (QB), R12.1
R5: IC2.4 (QE), R15.1
R6: IC2.5 (QF), R19.1
SHIFT_2_SER: IC1.9 (QH*), IC3.14 (SER)
SHIFT_3_SER: IC2.14 (SER), IC3.9 (QH*)
SHIFT_4_SER: IC2.9 (QH*), IC4.14 (SER)
SHIFT_RCLK: IC1.12 (RCK), IC2.12 (RCK), IC3.12 (RCK), IC4.12 (RCK), JP2.2
SHIFT_SER: IC1.14 (SER), JP2.1
SHIFT_SRCLK: IC1.11 (SCK), IC2.11 (SCK), IC3.11 (SCK), IC4.11 (SCK), JP2.3
SIDE_GREEN: IC4.2 (QC), SIDE_LEDS.5
SIDE_RED: IC4.1 (QB), SIDE_LEDS.6
VCC: IC1.10 (SCL), IC1.16 (VCC), IC2.10 (SCL), IC2.16 (VCC), IC3.10 (SCL), IC3.16 (VCC), IC4.10 (SCL), IC4.16 (VCC), JP3.1, JP4.1

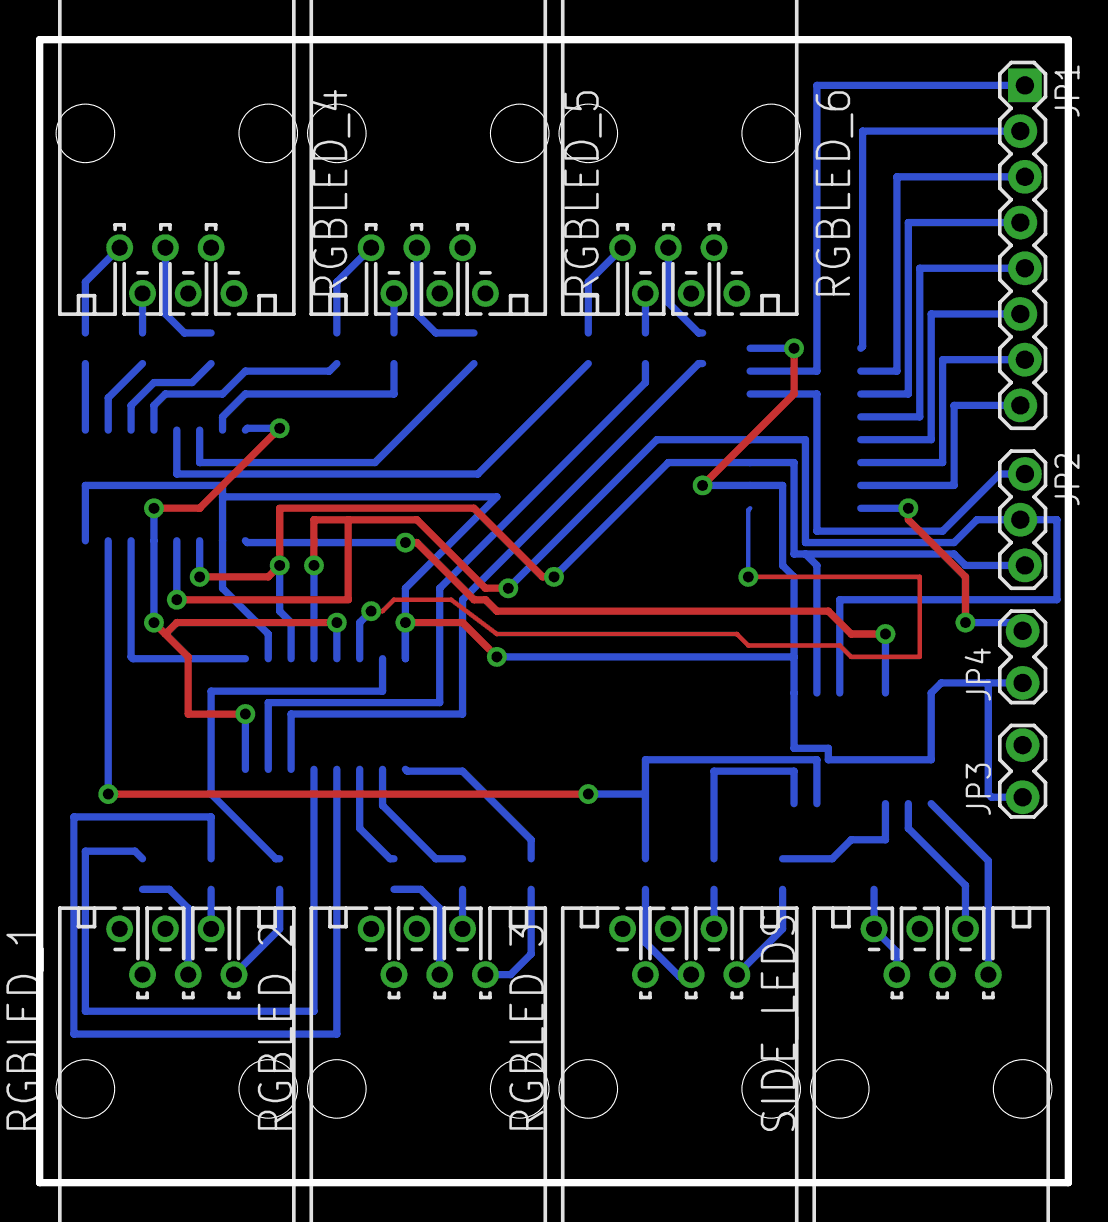
[picture p30: board LEDs - Schematic.brd from above]

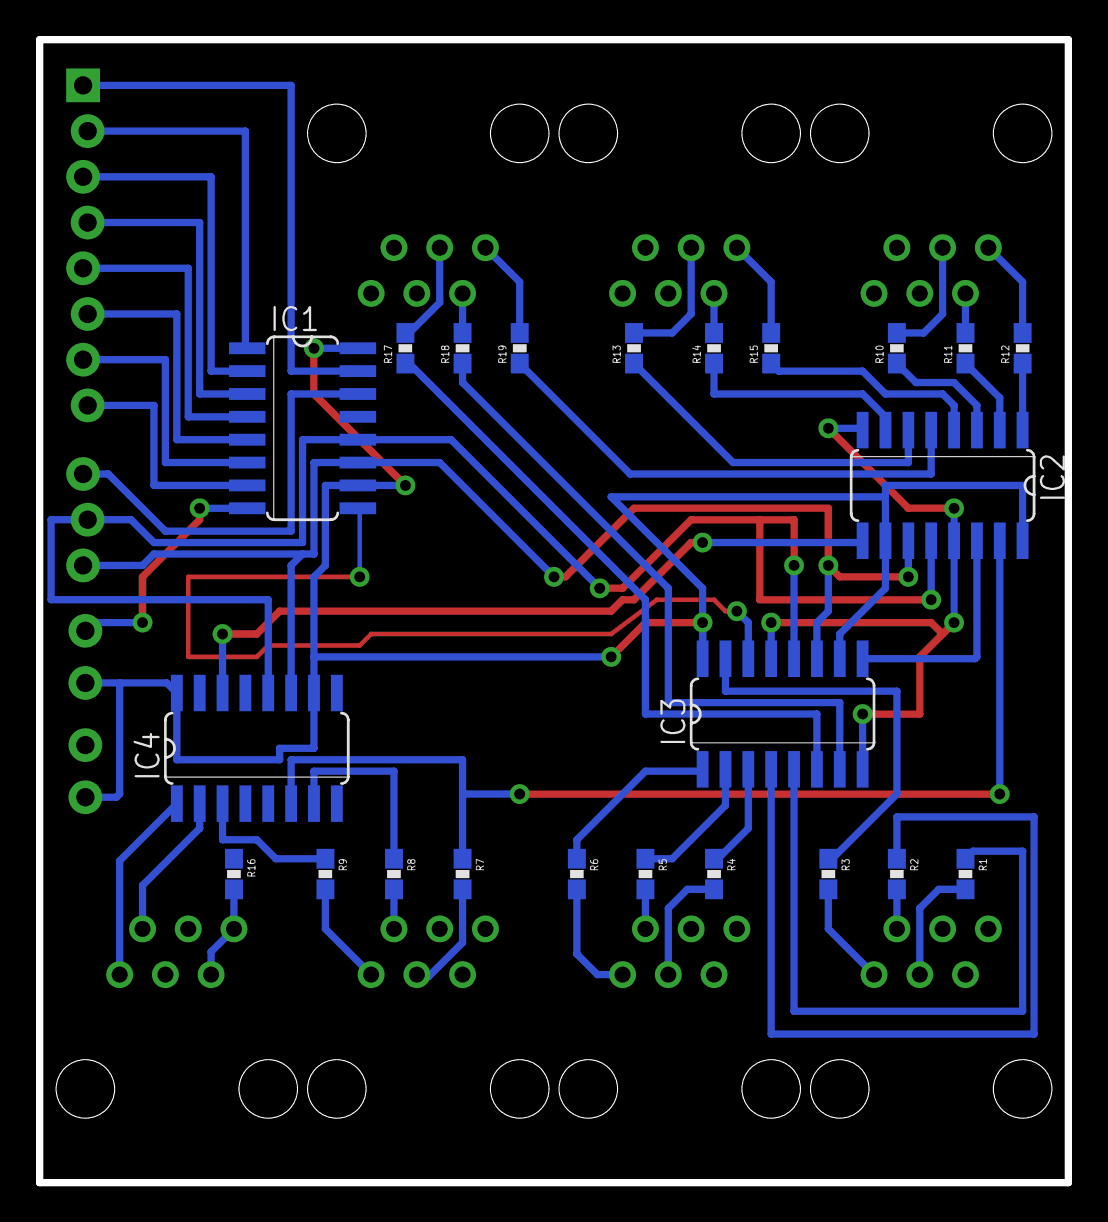
[picture p31: board LEDs - Schematic.brd from below]

Board: 2 copper layers, 57.1 x 63.5 mm, 34 parts (23 on the bottom side), 55 nets.
