kalutes/FRCDriversStation/Driver's Station Documentation/Eagle Files/Analog Breakout/Analog Breakout - Board.brd

## EAGLE design Driver's Station Documentation/Eagle Files/Analog Breakout/Analog Breakout - Board.brd (2016-06-20)

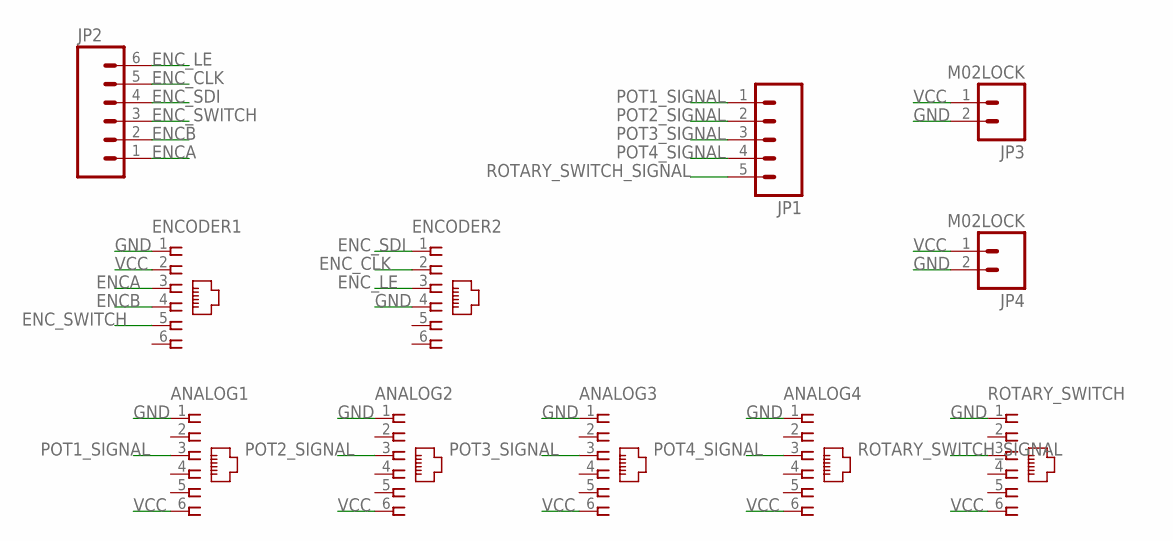
[picture p32: schematic Analog Breakout - Schematic.sch]

Parts:
ANALOG1, ANALOG2, ANALOG3, ANALOG4: 555165-1
ENCODER1, ENCODER2: 555165-1
JP1: M05LOCK; 1X05_LOCK
JP2: M06LOCK; 1X06_LOCK
JP3, JP4: M02LOCK; 1X02_LOCK
ROTARY_SWITCH: 555165-1

Connections:
ENCA: ENCODER1.3, JP2.1
ENCB: ENCODER1.4, JP2.2
ENC_CLK: ENCODER2.2, JP2.5
ENC_LE: ENCODER2.3, JP2.6
ENC_SDI: ENCODER2.1, JP2.4
ENC_SWITCH: ENCODER1.5, JP2.3
GND: ANALOG1.1, ANALOG2.1, ANALOG3.1, ANALOG4.1, ENCODER1.1, ENCODER2.4, JP3.2, JP4.2, ROTARY_SWITCH.1
POT1_SIGNAL: ANALOG1.3, JP1.1
POT2_SIGNAL: ANALOG2.3, JP1.2
POT3_SIGNAL: ANALOG3.3, JP1.3
POT4_SIGNAL: ANALOG4.3, JP1.4
ROTARY_SWITCH_SIGNAL: JP1.5, ROTARY_SWITCH.3
VCC: ANALOG1.6, ANALOG2.6, ANALOG3.6, ANALOG4.6, ENCODER1.2, JP3.1, JP4.1, ROTARY_SWITCH.6

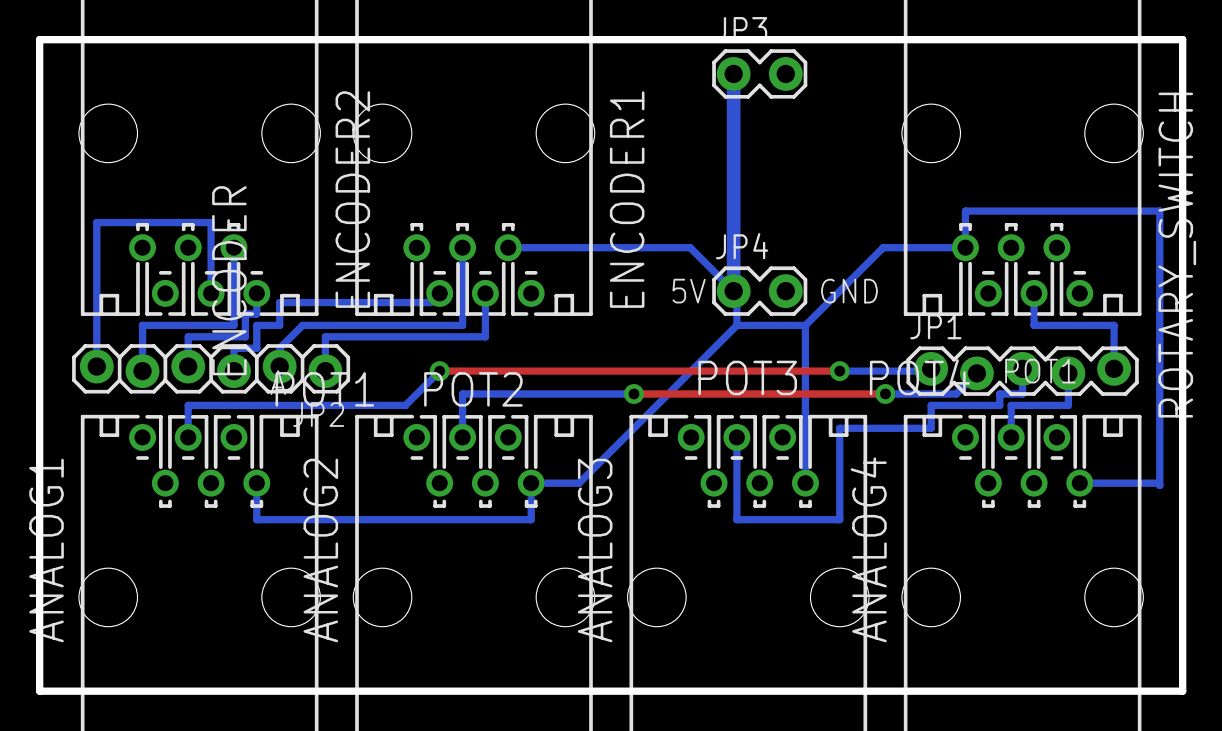
[picture p33: board Analog Breakout - Board.brd from above]

Board: 2 copper layers, 63.5 x 36.2 mm, 11 parts (0 on the bottom side), 13 nets.
