kalutes/FRCDriversStation/Driver's Station Documentation/Arduino Code/MegaJoy/ATmega8u2Code/HexFiles/dfu_programmer_install_src/dfu-programmer/config.h

/* config.h.  Generated from config.h.in by configure.  */
/* config.h.in.  Generated from configure.ac by autoheader.  */

/* Define to 1 if you have the <inttypes.h> header file. */
/* #undef HAVE_INTTYPES_H */

/* Define to 1 if you have libusb. */
/* #undef HAVE_LIBUSB */

/* Define to 1 if you have libusb-1.0. */
#define HAVE_LIBUSB_1_0 1

/* Define to 1 if your system has a GNU libc compatible `malloc' function, and
   to 0 otherwise. */
#define HAVE_MALLOC 1

/* Define to 1 if you have the <memory.h> header file. */
/* #undef HAVE_MEMORY_H */

/* Define to 1 if you have the `memset' function. */
/* #undef HAVE_MEMSET */

/* Define to 1 if you have the <stdint.h> header file. */
/* #undef HAVE_STDINT_H */

/* Define to 1 if you have the <stdlib.h> header file. */
#define HAVE_STDLIB_H 1

/* Define to 1 if you have the <strings.h> header file. */
/* #undef HAVE_STRINGS_H */

/* Define to 1 if you have the <string.h> header file. */
/* #undef HAVE_STRING_H */

/* Define to 1 if you have the <sys/stat.h> header file. */
/* #undef HAVE_SYS_STAT_H */

/* Define to 1 if you have the <sys/types.h> header file. */
/* #undef HAVE_SYS_TYPES_H */

/* Define to 1 if you have the <unistd.h> header file. */
/* #undef HAVE_UNISTD_H */

/* Name of package */
#define PACKAGE "dfu-programmer"

/* Define to the address where bug reports for this package should be sent. */
#define PACKAGE_BUGREPORT ""

/* Define to the full name of this package. */
#define PACKAGE_NAME "dfu-programmer"

/* Define to the full name and version of this package. */
#define PACKAGE_STRING "dfu-programmer 0.5.2"

/* Define to the one symbol short name of this package. */
#define PACKAGE_TARNAME "dfu-programmer"

/* Define to the home page for this package. */
#define PACKAGE_URL ""

/* Define to the version of this package. */
#define PACKAGE_VERSION "0.5.2"

/* Define to 1 if you have the ANSI C header files. */
/* #undef STDC_HEADERS */

/* Version number of package */
#define VERSION "0.5.2"

/* Define to empty if `const' does not conform to ANSI C. */
/* #undef const */

/* Define to rpl_malloc if the replacement function should be used. */
/* #undef malloc */

/* Define to `unsigned int' if <sys/types.h> does not define. */
/* #undef size_t */
