kalutes/FRCDriversStation/Driver's Station Documentation/Arduino Code/MegaJoy/ATmega8u2Code/HexFiles/dfu_programmer_install_src/dfu-programmer/src/dfu.h

/*
 * dfu-programmer
 *
 * $Id: dfu.h 93 2010-02-23 10:17:40Z schmidtw $
 *
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
 * You should have received a copy of the GNU General Public License
 * along with this program; if not, write to the Free Software
 * Foundation, Inc., 51 Franklin Street, Fifth Floor, Boston, MA 02110-1301, USA
 */

#ifndef __DFU_H__
#define __DFU_H__

#if HAVE_CONFIG_H
# include <config.h>
#endif
#ifdef HAVE_LIBUSB_1_0
#include <libusb.h>
#else
#include <usb.h>
#endif
#include <stdint.h>
#include <stddef.h>

#include "dfu-bool.h"
#include "dfu-device.h"

/* DFU states */
#define STATE_APP_IDLE                  0x00
#define STATE_APP_DETACH                0x01
#define STATE_DFU_IDLE                  0x02
#define STATE_DFU_DOWNLOAD_SYNC         0x03
#define STATE_DFU_DOWNLOAD_BUSY         0x04
#define STATE_DFU_DOWNLOAD_IDLE         0x05
#define STATE_DFU_MANIFEST_SYNC         0x06
#define STATE_DFU_MANIFEST              0x07
#define STATE_DFU_MANIFEST_WAIT_RESET   0x08
#define STATE_DFU_UPLOAD_IDLE           0x09
#define STATE_DFU_ERROR                 0x0a


/* DFU status */
#define DFU_STATUS_OK                   0x00
#define DFU_STATUS_ERROR_TARGET         0x01
#define DFU_STATUS_ERROR_FILE           0x02
#define DFU_STATUS_ERROR_WRITE          0x03
#define DFU_STATUS_ERROR_ERASE          0x04
#define DFU_STATUS_ERROR_CHECK_ERASED   0x05
#define DFU_STATUS_ERROR_PROG           0x06
#define DFU_STATUS_ERROR_VERIFY         0x07
#define DFU_STATUS_ERROR_ADDRESS        0x08
#define DFU_STATUS_ERROR_NOTDONE        0x09
#define DFU_STATUS_ERROR_FIRMWARE       0x0a
#define DFU_STATUS_ERROR_VENDOR         0x0b
#define DFU_STATUS_ERROR_USBR           0x0c
#define DFU_STATUS_ERROR_POR            0x0d
#define DFU_STATUS_ERROR_UNKNOWN        0x0e
#define DFU_STATUS_ERROR_STALLEDPKT     0x0f


/* This is based off of DFU_GETSTATUS
 *
 *  1 unsigned byte bStatus
 *  3 unsigned byte bwPollTimeout
 *  1 unsigned byte bState
 *  1 unsigned byte iString
*/

typedef struct {
    uint8_t bStatus;
    uint32_t bwPollTimeout;
    uint8_t bState;
    uint8_t iString;
} dfu_status_t;

int32_t dfu_detach( dfu_device_t *device, const int32_t timeout );
int32_t dfu_download( dfu_device_t *device, const size_t length, uint8_t* data );
int32_t dfu_upload( dfu_device_t *device, const size_t length, uint8_t* data );
int32_t dfu_get_status( dfu_device_t *device, dfu_status_t *status );
int32_t dfu_clear_status( dfu_device_t *device );
int32_t dfu_get_state( dfu_device_t *device );
int32_t dfu_abort( dfu_device_t *device );

#ifdef HAVE_LIBUSB_1_0
struct libusb_device
#else
struct usb_device
#endif
                     *dfu_device_init( const uint32_t vendor,
                                       const uint32_t product,
                                       dfu_device_t *device,
                                       const dfu_bool initial_abort,
                                       const dfu_bool honor_interfaceclass );

char* dfu_status_to_string( const int32_t status );
char* dfu_state_to_string( const int32_t state );
#endif
