kalutes/FRCDriversStation/(notices)

Notices in the files:
Driver's Station Documentation/Arduino Code/MegaJoy/ATmega8u2Code/HexFiles/dfu_programmer_install_src/dfu-programmer/src/dfu.c:
This program is free software; you can redistribute it and/or modify
it under the terms of the GNU General Public License as published by
the Free Software Foundation; either version 2 of the License, or
(at your option) any later version.
Driver's Station Documentation/Arduino Code/MegaJoy/ATmega8u2Code/MegaJoy.c:
the Free Software Foundation, either version 3 of the License, or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
parts and their libraries:
SparkFun-DiscreteSemi: Licensing: Creative Commons ShareAlike 4.0 International - https://creativecommons.org/licenses/by-sa/4.0
